sinara-hw/FMC_Shuttler/README.md

# Shuttler

16-channel 125MS/s 16bit DAC in FMC form factor.

## Design Files

Design files (schematics, PCB layouts, BOMs) can be found at [Shuttler/Releases](https://github.com/sinara-hw/Shuttler/releases).

## Wiki

More information can be found on the [wiki](https://github.com/sinara-hw/Shuttler/wiki).
