sinara-hw/FMC_Shuttler/(threads)

Thread 2 (2018-08-19):

[RFC] New AMC: Shuttler (high-speed multi-channel DAC)

marmeladapk, 2018-08-19:
_From @hartytp on [2017-08-16 05:24](https://github.com/sinara-hw/sinara/issues/253)_

I've started sketching out requirements for a fast DAC to be used for ion shuttling/splitting. It's on the [Wiki](https://github.com/m-labs/sinara/wiki/Shuttler).

All comments welcome...

tprzywoz, 2018-12-05:
Schematics are nearly done so question about AFE: what was the conclusion?
I noted only amplifier parameters: gain 3, supply +/- 2.5 V to give +/- 1.5 V at the output. Is it actual? What are the filter requirements?

dhslichter, 2018-12-05:
@tprzywoz answered in a new issue (this one is so bloated and long): https://github.com/sinara-hw/Shuttler/issues/3#issue-387849998

gkasprow, 2020-11-06:
nothing to discuss here, closing

Closed 2020-11-06.

Thread 3 (2018-12-05):

Shuttler AFE

dhslichter, 2018-12-05:
Breaking out to a new issue for the AFE design, in response to https://github.com/sinara-hw/Shuttler/issues/2#issuecomment-444438410.

LTC2000 wants a 25 ohm load impedance (40 mA output current for 1 V output).  There is already a 50 ohm termination to ground internally on the chip for each of IOUTP/IOUTN so we want to provide an additional 50 ohm termination to ground for each at the output pins.  Then we route traces over 25-ohm lines (50-ohm differential) to the AFE, using ADA4927.  One option is the solution below, gives 2 Vpk differential output (4V pk-pk) with 10.2 nV/rtHz differential output noise density.  Can't seem to get it much better by playing with components.
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

dhslichter, 2018-12-05:
@tprzywoz see above for an initial spec on AFE design, @gkasprow @hartytp check this out too and see if you have disagreements.

hartytp, 2018-12-05:
@dhslichter I'm going to let you lead on this design -- I already have enough on my plate with Sayma and all the EEMs I'm working on and don't have enough head space to contribute in a major way to this design review.

dhslichter, 2018-12-05:
@hartytp ack, I have been doing the same w/r/t Sayma and EEMs....

hartytp, 2018-12-05:
Divide and conquer... :)

gkasprow, 2018-12-05:
There is going to be another AFE outside of the Shuttler board?
We would need some control signals which need to be foreeen.
Did we finally decide which connector we should use? Shuttler can go up to 500MS/s (or even 800MS/s)  per channel, so I'm not really sure if SCSI is good choice here. We can use i.e. QSFP/SAS connectors and cables which have both 8 diff pairs and a few control signals.
With 3 such plugs we will connect all 18 channels + some high speed clock/data lines and a lot of LVTTL signals. The cables are available with various speed grades, so go up to 30GHz (3M Twinax)
You can get them [on cheap](https://www.amazon.com/CABLEDECONN-Internal-36-Pin-SFF-8087-Cable/dp/B00S7KU3PC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)
External ones are [more expensive](https://www.amazon.com/CableCreation-External-26pin-SFF-8088-Cable/dp/B013G4F5QK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), but still cheap.

gkasprow, 2018-12-05:
[These](https://cdn.amphenol-icc.com/media/wysiwyg/files/drawing/10117949.pdf) are nice cables. 8 diff pairs + 8 IO wires, rock solid connectors. It is external High Density SAS. Available i.e. [here](https://www.amazon.com/CableCreation-3-3FT-External-SFF-8644-Cable/dp/B01GPCTYEY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). One cay get them up to 10m long

dhslichter, 2018-12-05:
@gkasprow I have no desire whatsoever to try to run Shuttler past ~150 MSPS.  I understand that this doesn't make use of the full bandwidth of the DACs, but I don't want us to end up over-specing other components if there is no intent to go above ~150 MSPS.  I want to just make sure we keep this in mind as we develop.

That said, I imagine that the crosstalk on SCSI might be higher than we'd want, and that shielded differential pairs might be the best way to go.  I would want to use a reliable, COTS system, and these SAS and HD-SAS cables seem to be one option.

> There is going to be another AFE outside of the Shuttler board?
We would need some control signals which need to be foreeen.

Yes, there will be some kind of AFE to provide the final gain, filtering, differential-to-single-ended conversion that lives as close as possible to the ion trap.  Control signals might be nice to have if they are for free, but I had at least envisioned a "dumb" front end without things like switchable gain.  I also worry a little bit about digital crosstalk onto the analog signals if we send them down the same cable.  One could break out any digital signals into a separate cable/connector to address this.

gkasprow, 2018-12-05:
These digital signals go outside of twinax cables. They are usually loose wires inside plastic wrap. We can add also external connector, i.e. RJ45 and run LVDS signals over it for possible AFE control.

gkasprow, 2018-12-05:
SAS do not have side signalling, only HD-SAS and mini-SAS have ones.

dhslichter, 2018-12-05:
I would vote for RJ45/LVDS for digital AFE signals, and use the twinax cables for analog only.  Can you confirm the HD-SAS etc have individually shielded pairs?  I can't find a crosstalk spec anywhere (other than "at least 15 dB below insertion loss", which is not very tight), do you know of one?

gkasprow, 2018-12-06:
Yes, they do have individual pairs. They usually use 3M [twinaxial cables](http://multimedia.3m.com/mws/media/673519O/3mtm-twin-axial-cable-sl8800-series.pdf)
I use them in my projects so will measure the crosstalk.

gkasprow, 2018-12-06:
@tprzywoz please measure crasstalk of the twinax cables.

gkasprow, 2018-12-06:
@dhslichter why did you set Rs=25Ohm ? it is current output, so we need 50Ohm load impedance and traces can be 50Ohm as well.

dhslichter, 2018-12-06:
@gkasprow it is current output, but they want us to use 40 mA and have a 25 ohm load for the DAC to keep the output voltages between 0 and 1 V (+/- 1V differential), according to the datasheet.  There is a 50 ohm internal to the DAC, and we could use a 50 ohm transmission line and 50 ohm termination for the amplifier stage.  However, I am a little unclear because the DC path for the current feedback amplifier is such that we would end up running with 576 mV DC offset for the DAC channels, which would end up maybe giving us some issues with distortion as we go to full scale on the DAC.

If you look in the datasheet, they actually specify the DAC with 12.5 ohm total load (that is, 50 ohm DAC internal, 50 ohm DAC external, plus a 25 ohm load impedance at the front end of whatever following amplifier you're using).  This keeps the voltage swing down and I think ends up helping with the distortion

Here's a version with 25 ohm total load (50 ohm DAC plus 50 ohm at amp), showing what I mean about the DC offsets:
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

We can also turn the DAC current down (it can be set in a range between 10 and 60 mA) if that's easier, but it seems that spur performance is best at higher currents.  Anyway, this is something we should test -- I have an eval board but haven't had time to play around with it yet.

dhslichter, 2018-12-06:
regarding twinax, these look good (I remember your showing them before at some point).  It will be great to have a crosstalk measurement for verification but this seems like it would be a good solution.

gkasprow, 2018-12-06:
We have all HW needed to make crosstalk measurement.
I plan to attach 3 SMA connectors to the iPass connector where plug will be inserted.
I want to measure crosstalk between neighbouring pair and pair on opposite side of the connector.
Shall I attach baluns? Or just connect the signal to one of the diff pair wires and observe another?

dhslichter, 2018-12-06:
Ideally, baluns would be used, or single-ended-to-differential amplifiers otherwise.  We are looking for crosstalk at frequencies up to ~100-200 MHz max, so high-speed diff amps would work well also.

Just for a zeroth-order test, you could try putting a single-ended signal down one wire of one pair and see how much you see single-ended on a single wire of a neighboring pair.  That certainly gives a worse-than-worst-case crosstalk number.

Thread 4 (2018-12-06):

LVCMOS18 to LVDS - DAC data input

tprzywoz, 2018-12-06:
I made HyperLynx simulation of LTC-2000 data input lines with LVCMOS18 Kintex output. When single resistor was used as a DAC termination all results were nice like here https://github.com/sinara-hw/Shuttler/issues/2#issuecomment-414122354.

And now results with DAC ibis model:
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
Signal on + pin is shifted and also amplitude is reduced by the factor of 2.
I wrote a message to Analog support and i'm waiting for an answer because it could be ibis model problem but also something unexpected in internal termination circuit.

gkasprow, 2018-12-06:
The DAC datasheet says that VCM can be from 0.4V to over 1.5V.
But when we try to set 0.9V VCM it behaves like it was Thevenin terminated to roughly 1.2V inside.

dhslichter, 2018-12-06:
Be interesting to hear from Analog if this is an IBIS bug or if things are truly thevenin terminated inside.  The labels on the graph above are a little unclear -- does "DAC + input" mean pin DBP15?  If you put a resistor between the 0.9V bias and the DBN15 pin, can you figure out how strong the pull to 1.2V is?

tprzywoz, 2019-02-20:
The first answer after 2 months was: "We do not recommend driving the LVDS inputs single ended". I'm
 still trying to get more information...

gkasprow, 2019-02-20:
I ordered devkit  for LTC2000 so we will check it with Sayma AMC or other FPGA.

dhslichter, 2019-02-21:
thanks @tprzywoz @gkasprow.  Hopefully we can make this work, but if the IBIS model is right then we might be in trouble here.  We could think about using LVCMOS-LVDS bus translators like http://www.ti.com/product/SN65LVDS387 but these require 3.3V LVCMOS inputs (not sure we can get this out of all the FPGA banks) and consume about 280 mW each (!!).

gkasprow, 2019-02-21:
Anyway, even with 1.2V it should work. We will need to pull the matching network slightly up.

gkasprow, 2019-02-21:
@dhslichter the schematics are in the releases. Please have a look.

dhslichter, 2019-02-21:
Will look through schematics and let you know; it will probably be a couple of days before I can do through it all in detail though.

tprzywoz, 2019-02-26:
"The only way to test it to see if it is possible is to build it on the bench. "
So we are waiting for demo board...

tprzywoz, 2019-04-25:
Ok, so some results of test with DEMO 2303A.

Connections:
I connected demo board to Sayma_AMC and added 82R resistor to LTC2000 input (bit 14 - DBN14 and DBP14). It is not best termination but there is no other place to solder:
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
Kintex drives hi-z on all DAC data input pins except pin DBN14. DBP14 is connected to hi-z FPGA and also to resistive voltage divider (two 100R connected to DVDD1V8 - generate Vtt 0.9 V ) + capacitor 200nF.  Kintex output at DBN14 is LVCMOS18, DRIVE = 8, SLEW => SLOW.

Results:
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

I could change output voltage so we can drive LTC2000 with LVCMOS. There is a problem with oscillations when FPGA switches output but in my opinion it is only a consequence of the implemented "termination" (remember that distance between 82R termination and DAC is about 3 cm and I use resistive divider - not stable Vtt=0.9V).

gkasprow, 2019-04-25:
take into account that DAC is driven with 150MHz rate. So with such a poor matching, this looks good.

dhslichter, 2019-04-26:
Seems like a reasonable proof of principle!  What is the impact on power dissipation from the VT=0.9V on DBP14 drawing current from the DAC inputs?

tprzywoz, 2019-05-20:
Do you mean what is the impact of DAC inputs on VT circuit? I made another test: both FPGA outputs were hi-z, then I connected Vt to DBP14 with an ammeter. The result was 0 A.

gkasprow, 2019-12-22:
@tprzywoz please publish recent results that you included in your master thesis.

Thread 5 (2019-01-14):

DAC alignment

tprzywoz, 2019-01-14:
Do we need clock distribution to DACs with adjustable delay between channels?

dhslichter, 2019-02-12:
@tprzywoz @gkasprow the clock distribution for each DAC should be appropriately length-matched to the data traces for that DAC, but I don't think we care about whether these propagation delays are the same from DAC to DAC to less than ~1-2 ns (this should be very easy to achieve).  It is not important that the DAC outputs all update exactly synchronously.

gkasprow, 2019-02-18:
@dhslichter can you imagine application somewhere in the quantum lab where it could be important ?:)

jordens, 2019-02-18:
For very wideband applications the different group delays do make a difference and it would be nice to compensate then in hardware. Narrowband phase shifts are relatively easy to compensate in software.

dhslichter, 2019-02-19:
If it is easy to do, then go for it.  My main purpose is to avoid over-specifying the board in a way that makes it harder to design or more prone to failure/breakage.  @jordens I would think that any delays could be compensated for reasonably in software if desired.  I'm not clear on what you mean by "group delays" here?  Assuming this is all on the digital side that we are talking about, it's just a matter of whether the DACs are exactly synchronous in their output clocks (such that the phase is matched at the front panel analog output connectors, for example) or not.  While this is a nice goal in principle, I can't imagine that for fast ion trap electrode control (the goal of Shuttler) that sub-ns delay variation (static, mind you) would be an issue.

jordens, 2019-02-22:
Compensating for fractional, sub-sample, group delays in wide band applications is harder than compensating for a phase shift in a narrow band DDS. I would always prefer matching delays as good as reasonably possible on the board.

dhslichter, 2019-03-05:
I am fine with matching delays on the board as best as reasonably possible, no reason not to.  I just don't want to be doing crazy things for those last few picoseconds...

gkasprow, 2020-11-06:
not relevant here. we will have matched clock lines.

Closed 2020-11-06.

Thread 6 (2019-02-20):

Shuttler schematic review

tprzywoz, 2019-02-20:
I've just published schematics of Shuttler. I know that Sayma review must be done first to start Shuttler review, but I will be grateful for checking compliance with the expected specification -  I want to finish my master's thesis as soon as possible :)

gkasprow, 2019-07-24:
@tprzywoz Is this the last version of schematics? I want to introduce some changes and also do the review.

tprzywoz, 2019-07-24:
No, I changed the organization of FPGA schematics and fixed Sayma 2.0 issues that also affected Shuttler. I still have to finish some details. I'm going to push new version tomorrow.

tprzywoz, 2019-07-25:
I published the last version. What changes do we want to make?
My questions about potential changes:
As I understand a direct PORT0 connection to GTH is already working.  Can we remove ETH_PHY? / Do we want to wait for Sayma 2.0 to be sure?
Same question about Exar module.

gkasprow, 2019-07-26:
Let's leave as it is now. Do we miss some GPIOs?

tprzywoz, 2019-07-26:
If we want to implement EXT_CLK_IN / WR_REF_CLK_IN connected to FPGA then we need more IOs.
Also I thought about digital signals to control external AFE. Currently, we have 10 x 1.5V single-ended lines. We could add 3.3V lines without PHY.

gkasprow, 2020-08-14:
not relevant since we moved to FMC

Closed 2020-08-14.

Thread 7 (2019-02-21):

missing decoupling capas at the IC72

gkasprow, 2019-02-21:
There are FB connected to the supply pins. Aren't there missing decouplig caps?

gkasprow, 2019-02-21:
can the VOCM be left dangling?

dhslichter, 2019-02-21:
VOCM for the ADA4927s needs to be tied to ground.

tprzywoz, 2019-02-21:
> VOCM for the ADA4927s needs to be tied to ground.

Done

> There are FB connected to the supply pins. Aren't there missing decouplig caps?

Added according to datasheet: 1nF 100nF ceramic and 10uF tantalum capacitors for each supply.

dhslichter, 2019-02-21:
> Added according to datasheet: 1nF 100nF ceramic and 10uF tantalum capacitors for each supply.

Please make notations for voltage and dielectric spec (X7R or NP0) for the ceramic caps.  These amps may be driving a reasonable amount of current into the terminated transmission lines and so we want to make sure we don't have dc bias issues with the capacitors.

gkasprow, 2020-11-06:
it's not relevant anymore. we don't have any caps in the signal path in the FMC project.
I added a note on the AFE schematics

Closed 2020-11-06.

Thread 9 (2019-06-14):

Shuttler DAC parallel LTC2000 connection

tprzywoz, 2019-06-14:
I'm leaving results for future discussion.

As @gkasprow mentioned in #253 I made simulations for different FPGA output standards to check if it is possible to connect parallel LTC2000 (with internal LVDS termination) working with 150 MHz clock.

First configuration was 4 DAC to 1 IO bank of Artix-7. Only BLVDS standard meets the requirement of input voltage range (min +/- 200 mV). With 3 DAC we can use also SSTL18.

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
Example of schematic with 3 DAC

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
BLVDS simulation. Bit rate 600 Mbps.

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
SSTL18 simulation. Bit rate 450 Mbps

Closed 2019-06-14.

Thread 10 (2019-12-22):

DAC selection

gkasprow, 2019-12-22:
@tprzywoz finished layout of the board and want to close his master thesis. We decided that the main topic would be the optimization of the DAC connectivity that optimizes the price. He cannot wait longer for physical prototypes.
So, the question is what DACs should we choose? Do we stay with LTC2000 or can switch to a lower-cost alternative. I'd like to freeze the specification in early January.

dhslichter, 2019-12-23:
@gkasprow you should proceed however you see fit; we will still have to discuss the specification and I don't know whether this will be complete and ready to freeze by early January.  I think it is highly likely that we will NOT use the LTC2000 because of cost/power/complexity.  I am currently planning to target AD9117 as the DAC choice, with digital core at 1.8 V and analog at 3.3 V, tuned for 20 mA output current.  However, all of this is subject to discussion/initial testing/etc.  If you want to choose this DAC and freeze that spec for Shuttler 0.1, so that @tprzywoz can complete his thesis work, that is fine with me, however it is likely that we will have to come back and make various adjustments to do a proper Shuttler 1.0 design.

gkasprow, 2019-12-23:
We can switch to AD9117, I don't want to produce something that will be useless later on. What else would you like to change?

dhslichter, 2019-12-24:
Let me put up a draft spec in a day or two once there has been time for comment on my email to you and M-Labs.

gkasprow, 2020-11-06:
My colleague implemented dithering on this DAC devkit, he will test it and characterize within a 2..3 weeks. We can close it.

dhslichter, 2020-11-07:
@gkasprow we have been able to achieve 18 monotonic bits using dithering on a devkit for the AD9117 in tests at NIST before the pandemic hit.  The temperature coefficient is less well characterized, but appears to be helped by using an external reference.

gkasprow, 2020-11-07:
can you write more about the results and methods?

dhslichter, 2020-11-13:
Went into the lab and took some measurements today to verify the previous work.  The plot below shows the output voltage measured by a high-precision DVM with a slow time constant (~1 second) to reduce the noise.  There is a lot of pickup in the lab and the setup is definitely not optimized for noise, but this lets us see the trend at least.

The values here represent dithering around a major carry (digital codes 4095-4096) as well as with just the LSB flipping (codes 4096-4097).  The waveforms are very simple.  We output a looping digital waveform where for each 16 samples, the last (2,4,6,8,10,12,14) samples have a code one larger than the rest (e.g. 12 samples of 4095 followed by 4 samples of 4096 would be an average of 4095.25).  For some of the waveforms it was done in chunks of 32 samples rather than 16 samples, doesn't seem to make a difference with this extremely slow averaging.

In the end, this lets us get 3 extra effective bits that are nearly monotonic.  My student took some data several months ago showing 4 extra monotonic effective bits, but these were much closer to 0 V, and so less affected by gain errors/drifts.  These data are at the midpoint between 0 V and full scale (+/-1 V).

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

dhslichter, 2020-11-13:
Also took some measurements of temp coefficient.  I set up the DAC eval board with a temperature sensor IC bonded on top of the DAC chip with thermal paste, and then gently heat gunned the underside of the board and the surrounding box to get the temperature up to ~45-50 C.  Then I stopped the heat gunning and just recorded the output voltage along with the temperature of the sensor as the board slowly cooled back down to room temperature.  For an output of +1 V or - 1 V (full scale), I measured a voltage drift of 20 uV/C, with opposite signs (thus a gain drift of 20 ppm/C).  For an output of 0 V, the voltage drive was 1 uV/C.  These numbers are consistent with the datasheet, which claims a max gain drift of 40 ppm/C and a much smaller offset drift.

dhslichter, 2020-11-13:
The fluctuations of the output voltage at full scale on ~second timescales are fairly large, 10s of ppm, but this setup has basically not been optimized for noise at all.  I am a little nervous about these fluctuations, but I see so much pickup and switch mode spikes and such when looking at the output on an ac-coupled scope that I don't know how worried I should actually be.  It also appears that these fluctuations are smaller after some warmup period of 15 minutes or so.  This is something that will require much more careful lab setup and measurement if we want to get to the bottom of it.

gkasprow, 2021-01-24:
nothing to do here, closing

Closed 2021-01-24.

Thread 11 (2020-05-27):

[RFC] Shuttler GW/SW requirements specification

AAWO, 2020-05-27:
I've read through the issues regarding Shuttler and came up with requirements specification list. The final Shuttler's specification will also be a foundation for future ASIC (multi-channel DAC compatible with Sinara/ARTIQ) specification.

- 18 DACs (LTC2000) - PHY: 16 bit parallel output + clock each
- DRTIO Satellite interface
- DAC data rate = RTIO frequency -> single clock domain for DACs around 150MHz?
- data from DRTIO (all branches up to memory limit) is passed to SDRAM memory
- current waveform branch data is passed from SDRAM to proper DAC's sequencer FIFO - is such functionality already implemented in ARTIQ?
- 32-bit (16-bit?) timer counting until end point (received from DRTIO)
- each DAC's output waveform sample is updated when next sample's timestamp value is equal to current timer value
- a calibration procedure is needed to determine the latency between Master and Satellite's DAC output
- the raw data received from DRTIO is later on sent to DACs directly, or some DDS/interpolation is required?
- a single data packet received from DRTIO is (at proper time point) sent to DAC and dropped from memory/FIFO

I imagine the operation such that Master sends all experiment's data branches (DAC output value + timestamp + DAC ID + some branch ID) to Shuttler which stores it in the SDRAM - the amount of data sent by Master is constrained by the SDRAM. Then Master can send just current branch ID to Satellite.
Shuttler writes current data branch from SDRAM to required DACs' sequencers FIFOs. If the branch is changed before all data from FIFO is read, then FIFO is cleared and new data is written to it.
The timer can be started after Master's request. The timer's initial value should be dependent on the latency between Master and Shuttler's output as well as the delay between sending the 'start timer' request to next Shuttlers (which should be possible to determine by Master). This way all Shuttlers' timers should be aligned.

Part of the GW (namely: DAC handling) is going to be designed in Verilog, because later on it may be used as a test field for ASIC development.

dhslichter, 2020-05-28:
FWIW, although I have been occupied with other things these past couple of months, my current plan is to try to make a Shuttler design that is EEM/Kasli compatible, similar to how Phaser has been developed.  If others are interested in pursuing the specificiations above, perhaps we should branch or rename the EEM version to something else?

gkasprow, 2020-05-31:
Several questions arrive:
- would you need DRTIO? In new CPCIS form-factor, together with  ZUS+ the DRTIO in CPCIS will be supported. However, in EEM we would have a faster version of Fastino. Of course, we can connect DRTIO over SFP
- How many channels? We won't fit 24 probably. On the other hand if we use
XCKU035-1FFVA1156C, it's the same chip as CERN is using[ here](https://ohwr.org/project/diot/wikis/diot-fmc-carrier). We will get very good pricing, comparable with Artix
- what is the use case? how many channels would you need in total?
- if we go for CPCIS natively, we would get extra real estate and 24 channels would be feasible.

dhslichter, 2020-06-02:
Going for EEM would mean reduced channel count; I am also looking at ways to reduce power consumption by choosing different DACs and amps.  We were doing some DAC testing in the lab before the quarantine but that has been stopped, unfortunately.

If the CPCIS form factor works, that's great, but I am hesitant to be the guinea pig here.  My preference would be to develop a board as an EEM, which would allow us to get up and running, and ease the debugging process (as with Fastino and Phaser).  Down the road, if the design is proven out and there are advantages to using a single card as a DRTIO satellite, rather than running over EEM from Kasli, one could port a lot of the design over.

Total channel count desired would be something like ~100 for a given setup, possibly a bit more.  I think the primary limitation will be power dissipation in the rack, and thermal management.  I don't think we need 24 channels per card, 12-16 would probably be just fine.

gkasprow, 2020-06-03:
@dhslichter For the development of the Shuttler HW & GW we received already the research grant. It is clearly stated that it should support MTCA so we must somehow cope with it.
What if we make it in FMC form-factor? Then we could use it with low cost [AFC](https://ohwr.org/project/afc/wikis/home) carrier and also with [CPCIS FMC](https://ohwr.org/project/diot/wikis/diot-fmc-carrier) carrier. AFC/AFCK is well-tested solution (a few hundreds in operation), and now we are working on 4-th revision together with a few research institutions (CERN, LNLS, GSI, WUT).
The CERN CPCIS carrier uses very low cost (special Xilinx discount) Kintex US FPGA, already supported by ARTIQ.
With such an approach we could further fund the Shuttler development, meeting both funding agency goals as well as your requirements. We are working intensively with CERN on CPCIS, have suitable funding so soon the entire EEM ecosystem will be migrated to this ecosystem keeping full compatibility with existing EEM modules.
I already proved that [16-channel  * (ADC + CFD + TDC) ](https://github.com/elhep/FMC_ADC100M_10B_TDC_16cha/wiki)together with SAS connector is feasible on single FMC HPC.
I think 12-16 DAC channels per FMC can be done easily. I did a simple trick - the power section is placed on tiny mezzanine plugged to the FMC board and secured with 2 screws. Both boards are produced simultaneously with no additional cost.
With such approach, we will lower the cost significantly due to the economy of scale of AFC. The design and verification of such DAC would also be much lower risk and cost.
What we can do is to design two FMCs - one with LTC2000 and another with lower-grade DAC and see what approach is feasible in a real application.
In the past I already did 16-channel 14-bit [FMC DAC ](https://ohwr.org/project/fmc-dac100m14b16cha-adc2m14b4cha/wikis/home) and even managed to fit 4 ADC channels and some IOs.

kaolpr, 2020-06-04:
@dhslichter, @gkasprow - very interesting conversation. Interesting enough that it should have its own issue ;-). Please continue at #12 and let's leave this issue for comments on GW/SW specification as it seems to be at least partially independent.

kaolpr, 2020-06-04:
@dhslichter, @gkasprow - very interesting conversation. Interesting enough that it should have its own issue ;-). Please continue at #12 and let's leave this issue for comments on GW/SW specification as it seems to be at least partially independent.

AAWO, 2020-06-04:
> FWIW, although I have been occupied with other things these past couple of months, my current plan is to try to make a Shuttler design that is EEM/Kasli compatible, similar to how Phaser has been developed. If others are interested in pursuing the specificiations above, perhaps we should branch or rename the EEM version to something else?

OK, the form of the module, as well as the interface to ARTIQ is still to be discussed. Nevertheless, what about the rest of the proposed specification? Does it fit your use case?

dhslichter, 2020-06-12:
Replying to top post:

> 18 DACs (LTC2000) - PHY: 16 bit parallel output + clock each

Use AD9117 instead, 14 bit parallel LVCMOS bus with interleaved data (DDR)

> DRTIO Satellite interface

My current vision would be to have data streamed to a Shuttler from a Kasli, in the way that Phaser is done, so Shuttler itself would not need DRTIO.

> DAC data rate = RTIO frequency -> single clock domain for DACs around 150MHz?

Yes, 125 MHz (max clock for DAC, good general value for RTIO clock too)

> data from DRTIO (all branches up to memory limit) is passed to SDRAM memory

Again, I aim envisioning that reduced-representation data are streamed from Kasli to Shuttler.  The FPGA on Shuttler would be in charge of turning the reduced representation into samples at the full data rate.  For higher resolution, this MAY include performing sigma-delta modulation to increase the output resolution at ~DC.  Otherwise, would be simpler.

> current waveform branch data is passed from SDRAM to proper DAC's sequencer FIFO - is such functionality already implemented in ARTIQ?

Again, I envision this happening on Kasli.

> 32-bit (16-bit?) timer counting until end point (received from DRTIO)

Use the same architecture as for waveforms on Fastino or Phaser.

> each DAC's output waveform sample is updated when next sample's timestamp value is equal to current timer value

> a calibration procedure is needed to determine the latency between Master and Satellite's DAC output

Yes, TBA

> the raw data received from DRTIO is later on sent to DACs directly, or some DDS/interpolation is required?

See above, FPGA on board hosting Shuttler (via FMC, or directly) will need to do calculations to turn reduced representation of waveform into samples at full data rate.

>a single data packet received from DRTIO is (at proper time point) sent to DAC and dropped from memory/FIFO
> I imagine the operation such that Master sends all experiment's data branches (DAC output value + timestamp + DAC ID + some branch ID) to Shuttler which stores it in the SDRAM - the amount of data sent by Master is constrained by the SDRAM. Then Master can send just current branch ID to Satellite.

Let's do this in the same way that Fastino, Phaser, etc do it.

> Shuttler writes current data branch from SDRAM to required DACs' sequencers FIFOs. If the branch is changed before all data from FIFO is read, then FIFO is cleared and new data is written to it.
> The timer can be started after Master's request. The timer's initial value should be dependent on the latency between Master and Shuttler's output as well as the delay between sending the 'start timer' request to next Shuttlers (which should be possible to determine by Master). This way all Shuttlers' timers should be aligned.

Again, see above, do the same way as Fastino and Phaser.

kaolpr, 2020-08-27:
Comming back to GW specification:

>My current vision would be to have data streamed to a Shuttler from a Kasli, in the way that Phaser is done, so Shuttler itself would not need DRTIO.

Shuttler will be mounted on some FMC carrier (maybe [AFCv4](https://ohwr.org/project/afc/tree/wut_afc4) or CPCIe carrier like [this one](https://www.ohwr.org/project/diot-pfc-ku/wikis/home)). Such carrier can run in standalone mode or be a satellite to Kasli.

>Use the same architecture as for waveforms on Fastino or Phaser.

Up to my understanding, Fastino works in a different way than Phaser. If I'm to wrong, current GW for Fastino allows setting output levels at specified timestamps whereas [Phaser is AWG](https://github.com/quartiq/phaser). @dhslichter What architecture do you have in mind?

dhslichter, 2020-08-27:
I think the goal would be to be more like Phaser.  We're looking to have parameterized waveforms, with some combinations of sine waves and splines and products of these -- the specification needs to be determined still.  However, the waveforms would for sure be in some reduced representation that is not just (time, voltage) pairs.

kaolpr, 2020-08-27:
@dhslichter - how do you find the process of determining these specifications? Do you have any timeline for that? Do you think you can specifiy that?

dhslichter, 2020-08-27:
This is something that we want to contract with M-Labs to have them design for use with ARTIQ.  Are you wanting to design your own independent gateware to have it emit pulses, or are you planning to work with M-Labs on a solution for ARTIQ?  An official contract for this will take at least two months, maybe more.  However, if you are just doing your own independent thing to be able to demonstrate the functionality for grant purposes, we can just discuss a draft specification here on a short timescale.

kaolpr, 2020-08-28:
Is this contract going to give a rise to something more generic? I mean to be used throughout different boards, e.g. Sayma, Phaser, Shuttler, maybe Fastino? A generic waveform forming API for ARTIQ?

gkasprow, 2020-08-28:
The initial idea was to have just AWG functionality that is sufficient to run the production tests. If we can do easily something more sexy that makes the end-used happy, we can do that.

dhslichter, 2020-08-28:
> A generic waveform forming API for ARTIQ?

There already exist several different versions of this for e.g. Sayma and Phaser, and @jordens has proposed yet a separate parameterization in https://github.com/quartiq/phaser/issues/2 as well.  My general feeling is that the specific applications for ARTIQ are sufficiently varied that probably there isn't a one-size-fits-all method for generating all possible types of waveforms one wants.  Different use cases call for different parameterizations.

> The initial idea was to have just AWG functionality that is sufficient to run the production tests.

To be concrete, having waveforms defined as `A+B*sin(C*t)+D*cos(E*t)`, where `A,B,C,D,E` are all time-dependent functions decomposed into cubic splines, with arbitrary/adjustable time delays between spline knots, is a fine place to start for demonstrating functionality.  This is only one way in which one could parameterize outputs, and is probably NOT how things will end up in a written contract.

One feature of Shuttler that would be nice to implement, if you are looking for more of a challenge, is delta-sigma modulation of the output to increase the effective bit depth at DC to 16+ bits.  This could be an interesting gateware project if you are looking for something a little bit fancier to implement.  We did some test experiments at NIST with dithering to increase the low-frequency resolution and this should work.

dhslichter, 2021-04-28:
@gkasprow @AAWO my concrete suggestion for how to do the AWG in the gateware is as follows:

- implement a duplicate of the current PDQ gateware (adapted to whatever FPGA you are using).  Code and documentation are at https://github.com/m-labs/pdq and https://pdq.readthedocs.io/en/latest/
- this is a basic level functionality that will render the boards useful.  I suggest doing the computations of the output as 16 bit numbers, and then just round to 14 bits before sending to the DACs
- following this, there can be discussion of using sigma-delta modulation to increase the effective bit depth at DC.  The current work that has been done on random dithering with LFSR is appropriate for spreading noise, but doesn't do anything to increase effective resolution at DC.  For this you would want to use sigma-delta modulation.  There are hack-y ways to do this using dithering (not random dithering, though), which is why it was being discussed before, but probably sigma-delta is the right way to do.

gkasprow, 2021-04-29:
@kaolpr

dhslichter, 2021-05-14:
@kaolpr @gkasprow what is the status on this?  is there a gateware repo that exists somewhere?

kaolpr, 2021-07-06:
Generally we had some problems with DAC devkit we were working with. I'll looking into this in this month and hope to publish initial version of the gateware at the beginning of August.

dhslichter, 2021-07-06:
problems with devkit?  anything concerning?

gkasprow, 2021-07-06:
Devkit works with ADI software but for some reason doesn't work with ARTIQ. It looks like a DAC initialization problem.

dhslichter, 2021-07-06:
meaning that the SPI communications are broken?

kaolpr, 2021-07-07:
I was not actively taking part in the development up till now. I only know he couldn't get it working and I'll be looking into it as soon as I'm back from vacation (on 20th July).

This devkit exposes USB interface for programming DAC and clock tree configuration. From what I have seen so far, provided software is a bit confusing and I hope this is the source of the problem.

Thread 12 (2020-06-04):

Shuttler FMC

kaolpr, 2020-06-04:
During the conversation on HDL/SW specification, an idea of having Shuttler moved to the FMC modules has arisen. Let the authors speak:

>  @dhslichter FWIW, although I have been occupied with other things these past couple of months, my current plan is to try to make a Shuttler design that is EEM/Kasli compatible, similar to how Phaser has been developed. If others are interested in pursuing the specifications above, perhaps we should branch or rename the EEM version to something else?

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

> @gkasprow For the development of the Shuttler HW & GW we received already the research grant. It is clearly stated that it should support MTCA so we must somehow cope with it.
What if we make it in FMC form-factor? Then we could use it with low cost [AFC](https://ohwr.org/project/afc/wikis/home) carrier and also with [CPCIS FMC carrier](https://ohwr.org/project/diot/wikis/diot-fmc-carrier). AFC/AFCK is well-tested solution (a few hundreds in operation), and now we are working on 4-th revision together with a few research institutions (CERN, LNLS, GSI, WUT).
The CERN CPCIS carrier uses very low cost (special Xilinx discount) Kintex US FPGA, already supported by ARTIQ.
With such an approach we could further fund the Shuttler development, meeting both funding agency goals as well as your requirements. We are working intensively with CERN on CPCIS, have suitable funding so soon the entire EEM ecosystem will be migrated to this ecosystem keeping full compatibility with existing EEM modules.
I already proved that [16-channel * (ADC + CFD + TDC)](https://github.com/elhep/FMC_ADC100M_10B_TDC_16cha/wiki) together with SAS connector is feasible on single FMC HPC.
I think 12-16 DAC channels per FMC can be done easily. I did a simple trick - the power section is placed on tiny mezzanine plugged to the FMC board and secured with 2 screws. Both boards are produced simultaneously with no additional cost.
With such approach, we will lower the cost significantly due to the economy of scale of AFC. The design and verification of such DAC would also be much lower risk and cost.
What we can do is to design two FMCs - one with LTC2000 and another with lower-grade DAC and see what approach is feasible in a real application.
In the past I already did 16-channel [14-bit FMC DAC](https://ohwr.org/project/fmc-dac100m14b16cha-adc2m14b4cha/wikis/home) and even managed to fit 4 ADC channels and some IOs.

kaolpr, 2020-06-04:
Ops. Sorry for that.

dhslichter, 2020-06-12:
Doing developments on FMC seems to be a sensible idea.  One can then have the choice of different "carrier" boards as appropriate for MTCA/EEM/CPCIS, or just use a standard FPGA eval board to get things up and running (e.g. KC705).  I think a lot more of the questions come around what one chooses for the DACs, amps, etc.  Thinking about power budget, space constraints, and so forth.

Closed 2020-11-06.

Thread 13 (2020-06-12):

Shuttler DAC/amp design

dhslichter, 2020-06-12:
Proposal for Shuttler DAC and amplifier selection/design @gkasprow @kaolpr :

- DAC: [AD9117](https://www.analog.com/en/products/ad9117.html).  For output tones in the DC-15 MHz range (target), has very good noise/distortion/spurs.
    - two channels
    - 14 bits
    - 125 MSPS
    - 85 dBc SFDR, 82 dBc IMD for 10 MHz output tone
    - ~0.5 LSB DNL/INL spec after self-calibration (DNL tested OK, INL questionable)
    - -163 dBm/Hz noise floor @ 1 MHz, -157 dBm/Hz @ 10 MHz
    - use external reference, 1.25 VDC, ultra low noise and tempco desired.  Suggest [LTC6655](https://www.analog.com/en/products/ltc6655.html) as used in Fastino.  Gain tempco of DAC is spec'ed on data sheet at 40 ppm/C but this is with internal reference, which is not very good.  Measurement of gain tempco with good external reference still needed.
    - Use 3.3 V AVDD, 1.8V DVDD for reduced power consumption/improved SI (digital I/O is LVCMOS).  Using LVCMOS18 for digital interface also allows use with US FPGA or 7 series FPGA (no HR banks required).
    - 14-bit LVCMOS parallel data input bus runs DDR.  Some care is required to ensure deterministic latency from power-up to power-up, given de-interleaving re-timer (see datasheet).
    - SPI access also required for register programming
    - Estimated power dissipation ~100 mW/channel

- output: differential-to-differential output amplification with gain~5, made from one [ADA4896-2](https://www.analog.com/en/products/ada4896-2.html) per channel for good matching and very low noise.
    - 1.36 nV/rtHz, input referenced, including resistor noise effects, at G = 5 (see datasheet Table 13 for recommended resistor values)
    - amplifier GBW gives natural rolloff, might include pads for additional capacitor in feedback network to give further suppression of Nyquist image feedthrough if desired (option)
    - choose supply voltages to minimize dissipation (3 mA quiescent current per amp, 6 mA/DAC channel)
    - capacitive loads cause ringing, need some small series resistance to avoid problematic interactions with output cable capacitance

- board output would be differential voltages from output of amp stage, to be carried on 100 ohm differential pairs to remote AFE board.
- differential-to-single-ended conversion, additional gain, additional filtering, line termination, etc all on remote AFE board

- needs discussion/measurement:
    - DAC output/amplifier circuit topology and component values
    - DAC tempco measurements with external reference
    - output cable/connector specification
    - line termination scheme for remote AFE (will ac termination work OK?  reduces static dissipation, but introduces phase shifts)
    - choice of rails for output amplifiers

gkasprow, 2020-06-13:
For connectivity purposes, I'd like to use mini-SAS (internal ones since we have limited area on FMC). They have a 4-wire side channel that normally run SPI (HDD blinking LEDs). Cables are cheap and individually shielded, specified up to 12Gb/s. I use such cables in various analog designs.
What about supplying the remote AFE?
I did initial schematic and PCB placement, it looks feasible
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
The right-most PCB is a mezzanine with all supplies. I used this approach already and works fine. I will reuse already working module which delivers several low noise rails 1.8VA, 3.3V, 3.3VA,  5VA, -3VA
https://github.com/elhep/FMC_ADC100M_10B_TDC_16cha
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

gkasprow, 2020-06-13:
such FMC supports 16channels. Two double DAC chips are connected to same bus via level translator-buffer. It enables compatibility with both 2V5 and 3V3 VADJ boards.
The DACs have separate data and sampling clocks and require low Ts/Th of 0.25ns/ 1.2ns, so we have time to latch 4 data cycles per 8ns clock cycle. I want to use 74AVC20T245. Such buffers usually have skew below 1ns. In case of issues, we can run the board at 100MHz. This will probably require some calibration of clock phase using DCM or delay.
Another thing is the jitter. I assume we will operate it in wide-band mode, far away from sampling frequency, and use dithering, so clock jitter generated by FPGA is not an issue.

gkasprow, 2020-06-13:
It looks like we can also use DDR mode which will simplify timings a lot and use full DAC speed.
We have 34 * LVDS for LA
24 * LVDS for HA
22* LVDS for HB
Which gives 160 single lines.
To connect 16 DACs, we need 8 * 16 = 128 lines
Even if we restrict them to bank/clocking zones, we still manage to fit 16 channels.
Some XIlinx devkits have missing some HA and HB lines, but KC705 has them all; the AFC board can also work stand-alone.

gkasprow, 2020-06-14:
One word about the level translators. We actually don't need them because DACs work with 1.8...3.3V range. But I want to use them to isolate DAC from FPGA.

dhslichter, 2020-06-14:
Looking good, @gkasprow!  Some comments on the above:
- 16 DAC channels on an FMC would be high enough density for my purposes
- Let's plan to use DDR mode @ 125 MHz on the DACs, I would like to be able to run them up to full speed (125 MSPS/channel).
- Those level translators (SN74AVC20T245) don't look like they will run fast enough if translating to 1.8 V?  Datasheet quotes 210 Mbps at 1.8V output.  I prefer the idea of running the DVDD for the DACs at 1.8V, with the AVDD at 3.3 V.  We want the higher AVDD rail for better performance of the analog outputs, but can save ~25 mW per chip by using the lower DVDD rail (200 mW total for the board).  I also like the reduced potential for digital-to-analog crosstalk if we are using 1.8V DVDD.
- Why do you want to use a level translator?  I don't understand the need to isolate the DACs from the FPGA, sorry.  It seems to me that the potential for skew/timing problems is something we should avoid if we can.  Also, we will want to have a proper clock distribution system for the DAC clock, not using these translators, to get the best performance.
- Requiring a carrier board that has a fully populated HPC FMC (in order to run all the DACs) is fine with me.  KC705 has a fully populated HPC FMC so would work for this.
- I like the idea of a power mezzanine, but suggest we need some adjustments compared to the version you linked to above.  The rails we need are 3.3VA, -3VA, 1.8VD.  We want the lowest noise we can get here, as the experiment will be very sensitive to DAC noise.  Suggest LT3094 for -3V rail (to follow filtered buck reg TPS63710, as on current power mezzanine), and 2x LT3045 (one for DACs, one for amps) to supply +3.3V rail.
- suggest considering shielding cans for DACs?
- mini-SAS cables sound fine, side channel would be good to wire up for SPI communications (4 wire) between FPGA and remote AFE.
- remote AFE will have its own power supply.  Likely we will also break the grounds at the remote AFE (or at a minimum, maintain that option); since signals are fully differential coming out of the FMC, we can use a suitable differential-to-single-ended amp on the remote AFE to allow the grounds to float relative to each other within some acceptable range.

dhslichter, 2020-06-14:
Also: because DAC outputs are centered around 500 mV, we need a very low-noise 500 mV reference for the op amp noninverting inputs, so that the swing of the op amp outputs is correct for the gain.  It's OK if the output has a nonzero common mode voltage at DC, since the remote AFE will strip this off anyway.

gkasprow, 2020-06-14:
>    16 DAC channels on an FMC would be high enough density for my purposes
good

>    Let's plan to use DDR mode @ 125 MHz on the DACs, I would like to be able to run them up to full speed (125 MSPS/channel).

OK

>    Those level translators (SN74AVC20T245) don't look like they will run fast enough if translating to 1.8 V? Datasheet quotes 210 Mbps at 1.8V output. I prefer the idea of running the DVDD for the DACs at 1.8V, with the AVDD at 3.3 V. We want the higher AVDD rail for better performance of the analog outputs, but can save ~25 mW per chip by using the lower DVDD rail (200 mW total for the board). I also like the reduced potential for digital-to-analog crosstalk if we are using 1.8V DVDD.
>    Why do you want to use a level translator? I don't understand the need to isolate the DACs from the FPGA, sorry. It seems to me that the potential for skew/timing problems is something we should avoid if we can. Also, we will want to have a proper clock distribution system for the DAC clock, not using these translators, to get the best performance.

I had issues with 16bit ADC coupled with FPGA. The FPGA generates a lot of ground-bouncing noise. It adds up to the digital lines. The result was that I lost 2 LSBs and got funny patterns on the image (the ADC was part of CCD camera electronics). We can try without buffers in case of these DACs, because they have 14bits and don't have a fragile sampling and hold circuit.

That's why I was asking about jitter. If all DACs will run with the same frequency, I will add proper clocking, which will also deliver copy of clock to every FPGA bank used for DAC control.

   > Requiring a carrier board that has a fully populated HPC FMC (in order to run all the DACs) is fine with me. KC705 has a fully populated HPC FMC so it would work for this.

>    I like the idea of a power mezzanine, but suggest we need some adjustments compared to the version you linked to above. The rails we need are 3.3VA, -3VA, 1.8VD. We want the lowest noise we can get here, as the experiment will be very sensitive to DAC noise. Suggest LT3094 for -3V rail (to follow filtered buck reg TPS63710, as on current power mezzanine), and 2x LT3045 (one for DACs, one for amps) to supply +3.3V rail.

we will produce the supply mezzanine anyway, together with FMC. The existing design uses ADM7171 and ADP1740 LDOs for positive rails
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
And such circuit for negative rail.
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

The system was 8-bit so noise was not that important.

>    suggest considering shielding cans for DACs?

Do you mean to shield it against power supply mezzanine noise? We can make the bottom layer as a solid copper. I'd rather add it to the AFE circuit, but don't think it's necessary.
I can try if there is a place for it. If we scrap the digital buffers, the shield should fit.

>    mini-SAS cables sound fine, side channel would be good to wire up for SPI communications (4 wire) between FPGA and remote AFE.

We would have 4 wires per each 8 channels

 >   remote AFE will have its own power supply. Likely we will also break the grounds at the remote AFE (or at a minimum, maintain that option); since signals are fully differential coming out of the FMC, we can use a suitable differential-to-single-ended amp on the remote AFE to allow the grounds to float relative to each other within some acceptable range.

If we break the GND, additional passive CMC may be necessary

>Also: because DAC outputs are centered around 500 mV, we need a very low-noise 500 mV reference for the op amp noninverting inputs to make a proper fully differential amplifier circuit. It's OK if the output has a nonzero common mode voltage at DC, since the remote AFE will strip this off anyway.

So, we could avoid -3V rail ?

dhslichter, 2020-06-15:
> we will produce the supply mezzanine anyway, together with FMC. The existing design uses ADM7171 and ADP1740 LDOs for positive rails

I saw that schematic already, and the noise needs to be lower.  That's why I requested those other LDOs instead.  I would suggest just making a variant of that mezzanine (same board size/footprint, but different part numbers) that will meet the needs of this board better.

> So, we could avoid -3V rail ?

No, I don't think so, because we want a gain of ~5 on Shuttler itself.  This means that each of the differential outputs (after amplification) swings +/- 2.5 V from the output common mode voltage.  We want something like this amount of gain on Shuttler (in other words, not putting it all on the remote AFE board) to help mitigate noise pickup which may occur between Shuttler and the remote AFE, and because this level of gain represents a nice compromise in terms of graceful bandwidth rolloff (and avoiding peaking), input-referred noise, and power dissipation (due to the supply voltages needed).  It also reduces the amount of gain required on the remote AFE, which could then be a single-stage amp instead of needing two stages.

> If we break the GND, additional passive CMC may be necessary

Why?  I am not opposed necessarily, but I feel vaguely like they have caused some difficulties in other projects, right?

> We would have 4 wires per each 8 channels

I think that's plenty.  Depending on what one wants to do with the remote AFE board, these could be used to configure or read back data from a number of different things (analog switches, controllable gain, calibration ADCs, etc).  These are the HD mini-SAS, correct?

> Do you mean to shield it against power supply mezzanine noise?

The shielding would be for power supply noise from the mezzanine, or digital switching noise from the nearby FPGA, or from neighboring cards in the rack, or....basically, this is my paranoia wanting to be careful with these signals.  Careful routing of the analog signals should probably already win us a lot (internal layers with ground planes top and bottom and vias on the sides, for example).

> If all DACs will run with the same frequency, I will add proper clocking, which will also deliver copy of clock to every FPGA bank used for DAC control.

Yes, all the DACs would run at the same frequency.  This sounds good.

dhslichter, 2020-08-23:
Why do we have a P5V0 rail?  This will be the positive supply rail for the output op amps, right?  That can be 3.3 V for reduced power dissipation.  The DACs have a V_CM of 500 mV and swing between 0 and 1 V; with G=5 the output signal will have a common mode voltage of 500 mV again, with output voltages swinging between +3V and -2V.  The op amps are rated to run with 200 mV headroom on the rails, so this would still be OK.  We could move the 3.3 to 3.5 V, for example, if we were worried.

gkasprow, 2020-08-24:
I want to have a separate rail for opamps. It does not have to be 5V. We will reduce it to something like 3.5V.
The opamps have usually poor performance close to the supply rails. If we finally decide and test that 3.3 is enough, we can remove this rail.

dhslichter, 2020-08-24:
I think we should have a separate rail for the op amps -- I was just suggesting that we reduce the voltage from 5 V to ~3.5V.  We can have rails at -2.5 V and 3.5 V so that we have 500 mV headroom either direction, and can increase both directions a little if we need to.

Another reason we need a separate rail is that a single LT3045 won't be able to run all the DACs and all the op amps -- it only does 500 mA max.  The op amps will draw 16 * (2*3) ~ 100 mA quiescent current, and will be drawing more based on the terminations at the AFE.  The DACs draw (55 * 8) = 440 mA on the AVDD rail.  One rail for DACs, one rail for op-amps sounds good.

gkasprow, 2020-11-15:
@dhslichter did U have a chance to check the FMC card design? I'd like to start routing it ASAP because the project deadline is close.

dhslichter, 2020-11-17:
@gkasprow sorry slammed but will do tonight (USA time)

Thread 14 (2020-06-13):

AFE & supply

gkasprow, 2020-06-13:
What are the plans for supplying the  remote AFE?

dhslichter, 2020-06-15:
Remote AFE is a separate board entirely, with its own independent power supplies.  We just need to specify the interface between the remote AFE and the Shuttler FMC card for the analog signals, as well as for the digital (SPI) signals in the side channels of the cables.

My proposal:
- analog signals are provided over external mini-SAS
- analog signals are differential, with nominal common-mode voltage 500 mV (referenced to FMC ground)
- remote AFE should be configured as instrumentation-amplifier-type circuit to perform differential-to-single-ended conversion, provide gain, and tolerate common-mode offset of up to ~few V (high-impedance inputs, allows potential use of separate ground for remote AFE/ion trap that is not closely coupled to computer/FPGA ground)
- remote AFE provides differential termination (100 ohm, possibly ac coupled with knee at ~1 MHz).
- digital lines in side channels are all opto-isolated at remote AFE with DIP-switch-selectable line directions.

gkasprow, 2020-06-16:
sounds good. What supply range do you need?
Would you like to supply it from [Aux Power Suply](https://github.com/sinara-hw/meta/issues/48)?
Or from standard 12V wall wart (bad idea); or, some low noise +/- 12V bench supply?

dhslichter, 2020-06-17:
Let's defer the discussion of the remote AFE for the immediate time being.  My vision is that this should be a fairly simple "physicist"-type board.  We will likely want to put some reasonable consideration into the power supply, including noise testing.

gkasprow, 2020-06-17:
What voltage ranges do you expect at the ion trap electrodes?

dhslichter, 2020-06-19:
It will depend on the trap!  That's why we should leave the remote AFE as a separate task and not worry too much for now.  I'd say a "generic" value people have used in the past is +/- 10 V, but some may want +/- 20 V, +/- 50 V, ....

dhslichter, 2020-06-19:
The point is that different traps may call for different AFE designs.  I would like to leave the remote AFE as completely separate now and not worry about it, other than specifying 1. the connector it must use, 2. the termination for the analog signal, and 3. the ground potential difference it can tolerate relative to the Shuttler card.

gkasprow, 2020-06-19:
True, but we need something at the end of the cable to properly characterize the FMC design. Something simple that meets at least a typical use case.

dhslichter, 2020-06-19:
For a simple output board, use something with +/- 12 V or +/- 15 V output rails (could be moved up or down a bit as needed), with differential-to-single-ended conversion and a target gain of 2 or 2.5.  This would give a total output swing between +/- 10 V (or +/- 12.5 V).  A typical instrumentation amplifier or difference amplifier probably won't work because the bandwidth is not high enough (we would like ~15+ MHz bandwidth ideally).  Probably will need to build the circuit out of discrete op amps such as [LM6172](https://www.ti.com/product/LM6172) or [THS3121](https://www.ti.com/product/THS3121).  These have sufficiently high slew rate, low noise (including at low frequency -- we care about the 1/f voltage and current noise below 1 kHz), and low quiescent current.  Configure as a 3-op-amp instrumentation amplifier?

dhslichter, 2020-06-19:
The [LT1995](https://www.analog.com/en/products/lt1995.html) is another option with pin-strapped gain and internal resistors.  The resistors are not super well-matched, and the quiescent current of 9 mA means ~300 mW quiescent dissipation PER CHANNEL at +/- 15V supplies.  I would prefer to use discrete op amps with matched resistor arrays like this https://www.digikey.com/product-detail/en/vishay-beyschlag/ACASA1001S1001P100/749-1015-2-ND/4725768 which have 0.05% resistance match and 15 ppm/C tempco match for less than $1/channel, to build the difference amplifier stage.  Can use one resistor array for the buffers w/ gain, another for the subtractor stage.   Using +/- 15 V supplies with +/- 10V output voltage gives us some headroom to allow for common-mode voltage difference between the remote AFE and the FMC card.  Using a CMC on the input of the remote AFE would help raise the CMRR further at high frequency.

gkasprow, 2020-06-20:
Athat about the AFE form factor? Some Hammond extruded enclosure? What output connectors to the trap?

dhslichter, 2020-06-20:
Output to the trap: 25-pin d-sub for now, people can think about if they want to get fancier later.
AFE form factor: yes, probably would live in some cast aluminum box (not extruded).

dhslichter, 2020-08-23:
> Let's try to fit into the smallest one
> 100x50mm

Heat load will be a major consideration here.  Each LM6172, with +/- 15V supplies, has 138 mW quiescent dissipation, and we will use 1.5 per channel.  With 16 channels, this is 3.3 W quiescent dissipation.  This will of course be increased if there is lots of slewing going on.  I think it would be good to plan for some mechanism of heat sinking the op amps directly to the case.  We will also want to use a matched resistor array with a very good tempco matching between resistors, so we maintain good common-mode rejection over temperature.

gkasprow, 2020-08-24:
what about attaching the box to the optical table? Or, you don't want to dissipate heat there to keep the optics temperature stable. We can also attach the heat sink to the enclosure bottom and make good contact between PCB and the box wall.
In such case we need a bigger box since components will be mounted on one side

dhslichter, 2020-08-25:
In general you don't want to use the optical table as a heat sink.  My point was that yes, we may need a bigger box because we don't want the AFE to get too hot and that means heat sinking to the box itself.  It might be preferable to have a custom-machined aluminum pedestal for the PCB, (this can be done very cheaply) that then bolts to the inside of the box.  One could have large exposed (no silkscreen) metal ground pads on the backside that are then held in contact with the pedestal using screws.  You can carve out cavities in the pedestal for components on the back side, through-hole pins, etc.

gkasprow, 2020-10-20:
LEt's make it compatible with the [AUX_PSU](https://github.com/sinara-hw/AUX_PSU)

gkasprow, 2020-10-20:
@dhslichter This is the first iteration of possible AFE. We can use standard Hammond 1590BB2F die cast aluminium box.
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

The PCB is bolted to the laser-cut 2mm metal sheet that is later on bolted to the die-cast box. Only THT and some RC holes are cut in the sheet. This is super-cheap, less than 1$ per such sheet.
The upper cover has cutouts for connectors. It's also cheap to machine them in such way.
The LEDs are only for testing - the DIOs are optically isolated and drive the SPI register which controls LEDs.

gkasprow, 2020-10-20:
what about such AFE schematic?
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

gkasprow, 2020-10-20:
I assume you don't need variable gain or switchable filter.

dhslichter, 2020-10-22:
- At least for now, we don't need variable gain or a switchable filter.  This can always come later on some fancier designs if people want it.  I think resoldering is probably the best option rather than trying to implement hot switching, but it's worth thinking about in the longer run.
- I would use an ac termination for the input, otherwise we will have a needlessly large current draw on the Shuttler card itself.  I think at a minimum we should have pads to allow either RC termination or R=100 ohm termination (can just put a 0R on the C pads).  For starters, we might set the corner frequency at ~2 MHz (should be OK, assuming few-meter cable lengths), and one can always adjust this later in the testing stages by changing the capacitor value.
- It seems that R3 and R5 should match R1 and R8, and R6 should be larger?  Currently it looks like the gain of this circuit is ~100, we want gain ~2 or 2.5 IIRC (depends on exact gain on FMC card)

- One thing we could considering placing would be the ADC we are contemplating using to allow for calibration/slow feedback on voltages.  I would recommend using something like the [AD4115](https://www.analog.com/en/products/ad4115.html), which could basically be used to monitor all 16 channels and send measured values back over SPI.
    - AD4115 can handle voltages in the range +/- 20 V on each pin (single-ended measurements).  No external components required.  Could read directly from the output of the buffer amplifier (before R4/C5, to eliminate errors due to voltage division with ~1 MOhm input impedance of ADC).
    -  In order to correct for both gain and offset in the Shuttler DACs (e.g. due to temperature drifts), one would ideally be able to make measurements with several different output voltages.  However, if you have ions in the trap this might not be possible (i.e. voltages have to stay the same, or within some small range).  Therefore I think it might be useful to have an analog switch to disconnect the output connector from the AFE circuit.  The filter capacitors on the trap will maintain their voltages reasonably well for the duration of each calibration (~some milliseconds).  A relay would be best for this (low on resistance, high off resistance, no charge injection) but may not fit.  Analog switches are another option but on resistance and charge injection are important considerations.  The AD4115 has 4 programmable digital output pins which could be used with a 4:16 decoder circuit to control which switches are opened to allow DAC calibration.  All programmable over SPI, makes things simpler.

    -  The AD4115 has internal registers to allow compensation for ADC offset and gain error (one-time calibration).  It might be useful to have test points (doesn't need to be panel-accessible) to connect a laboratory precision calibrated voltage source for each of the ADC channels, so that one could calibrate the offset and gain for each ADC channel and send this information along on a datasheet for the board.  Tempco for gain and offset are very small (few ppm) so these calibrations would probably be

dhslichter, 2020-10-22:
output connector - is this 25 pin D-sub?

dhslichter, 2020-10-22:
In terms of relays to enable the DAC calibration sweep, I would recommend something like this part: [Pickering 109-1-B-5/2D](https://www.pickeringrelay.com/product/109-1-b-5-2d/).  SPST NC reed relay, switch/bounce times <1 ms, very small form factor (can fit 16 channels into 64 mm x 15 mm board area, we would just need to size up the Hammond box slightly), operates from 5 V with 7 mA, so we can drive directly from TTL/CMOS decoder, integrated diode.  A little pricey at $7 each, but I think we will want the ability to do frequent automatic calibrations on Shuttler.  One can make a board variant where the relays are bypassed by a jumper, so people can DNP and save money if they want.  We can get less expensive relays (<$2 each, saves $80/board) if we are able to use a bit more board space (100 x 20 mm) and use 1 Form A relays (normally open), which would mean dissipating 800 mW for keeping all the relays closed all the time unless calibrating.

gkasprow, 2020-10-22:
The connector is a high-density 26pin DSUB. Any preference here?

gkasprow, 2020-10-22:
@dhslichter there are also [OPTO-MOS](https://datasheet.octopart.com/AQY212EHAX-Panasonic-EW-datasheet-13536469.pdf) switches that have very low charge injection due to lack of steering circuit connection. It's a LED + solar cell + FET. 1.2$/pc

gkasprow, 2020-10-22:
Do you mean having one output connector for external precise DMM and 16 relays to selectively connect it to the AFE outputs?
And yet another 16 relays to disconnect the AFE from the trap?

gkasprow, 2020-10-22:
These [relays](https://www.pickeringrelay.com/product/116-1-a-5-2d/) are smaller and cheaper

dhslichter, 2020-10-22:
> Do you mean having one output connector for external precise DMM and 16 relays to selectively connect it to the AFE outputs?
And yet another 16 relays to disconnect the AFE from the trap?

No, I had in mind 16 relays to disconnect the AFE from the trap, and 16 test points (between output buffer and relay, on each channel), for a precision DMM (or a precision input source, alternatively, with output buffer powered off but ADC powered on).  This would only be accessible with the box open, you just do the calibration once as part of board test.  Another way to do this would be to have an external testing jig that plugs into the output connector, with switchable relays on that testing jig to connect to a DMM.  The issue there is that one has a voltage divider effect with the series output resistance of the RC filter and the DMM input impedance, which could be noticeable at the 16-bit level depending on DMM input impedance (10 MOhm vs 47 ohm = 4 LSB, for example).  If you have a >1 GOhm input impedance DMM then this is the simplest way to go, though, and you don't need the test points.

> @dhslichter there are also OPTO-MOS switches that have very low charge injection due to lack of steering circuit connection. It's a LED + solar cell + FET. 1.2$/pc

If an OPTO-MOS switch has low enough charge injection at the level we care about (we need charge injection to be ~10s of pC maximum, ideally less, over the entire range of source and drain voltages of the switch), it could work.  We also want the resistance to be low (<1 ohm is fine) e.g. AQY211EH.  We also want the on-state resistance to be independent of drain and source voltages; I suppose you get this with an opto-isolated relay but not with a typical semiconductor analog switch.

> The connector is a high-density 26pin DSUB. Any preference here?

Mostly it comes down to whether there are good, well-constructed shielded cable assemblies available.  Have you had good luck finding these with this type of connector?

> These relays are smaller and cheaper. And fit nicely

Yes, those were some of the ones I was looking at.  We will dissipate 800 mW steady state just running them, but if the rest of the board is already dissipating 3.3 W steady state maybe this isn't the end of the world.  These are slightly smaller footprint than the OPTO-MOS but it's similar.

Board design with relays looks nice, seems like things fit well!

dhslichter, 2020-10-22:
Another consideration with the optical relay is what the capacitance to ground is -- appears that there is a substantial voltage dependence of capacitance to ground, which would cause signal distortion.  If so we should avoid this.

gkasprow, 2020-10-22:
> > Do you mean having one output connector for external precise DMM and 16 relays to selectively connect it to the AFE outputs?
>> And yet another 16 relays to disconnect the AFE from the trap?

> No, I had in mind 16 relays to disconnect the AFE from the trap, and 16 test points (between output buffer and relay, on each channel), for a precision DMM (or a precision input source, alternatively, with output buffer powered off but ADC powered on).  This would only be accessible with the box open, you just do the calibration once as part of board test.  But now I think I see this is dumb, and a better way to do this would be to have an external testing jig that plugs into the output connector, with switchable relays on that testing jig to connect to a DMM.  The issue there is that one has a voltage divider effect with the series output resistance of the RC filter and the DMM input impedance, which could be noticeable at the 16-bit level depending on DMM input impedance (10 MOhm vs 47 ohm = 4 LSB, for example).  If you have a >1 GOhm input impedance DMM then this is the simplest way to go, though, and you don't need the test points.

What about using Hi-Z opamps + opto MOS switches? Of course this would add some capacitance and offset (a few tens of uV).
They could be cheaper than relays and would have one output for DMM

>> @dhslichter there are also OPTO-MOS switches that have very low charge injection due to lack of steering circuit connection. It's a LED + solar cell + FET. 1.2$/pc

>If an OPTO-MOS switch has low enough charge injection at the level we care about (we need charge injection to be ~10s of pC maximum, ideally less, over the entire range of source and drain voltages of the switch), it could work.  This is not specified in the datasheet and so would have to be measured, though (simple measurement).  We also want the resistance to be low (<1 ohm is fine) e.g. AQY211EH.  We also want the on-state resistance to be independent of drain and source voltages; I suppose you get this with an opto-isolated relay but not with a typical semiconductor analog switch.

they are 2-wire devices. They don't have a reference to GND, these are very low capacitances of optical bareer
The question is if leakage of disabled switch is acceptable

>> The connector is a high-density 26pin DSUB. Any preference here?

>Mostly it comes down to whether there are good, well-constructed shielded cable assemblies available.  Have you had good luck finding these with this type of connector?

You need to make the cable yourself. There are metal shields for DSUB connectors easily available.
We can also use fully shielded cables like SAS, but manual assembly could be problematic

>> These relays are smaller and cheaper. And fit nicely

>Yes, those were some of the ones I was looking at.  We will dissipate 800 mW steady state just running them, but if the rest of the board is already dissipating 3.3 W steady state maybe this isn't the end of the world.  These are slightly smaller footprint than the OPTO-MOS but it's similar.

Unfortunately they are not available as NC versions

dhslichter, 2020-10-22:
> What about using Hi-Z opamps + opto MOS switches? Of course this would add some capacitance and offset (a few tens of uV). They could be cheaper than relays and would have one output for DMM

If I understand correctly, this means putting on another set of 16 opto MOS switches -- one set to allow the output to be disconnected from the op amp (so that the voltages can be changed around for calibration), and another set to allow the op amp outputs to be routed to the single DMM connector.  Is that right?  Do we have enough space for that?

> they are 2-wire devices. They don't have a reference to GND, these are very low capacitances of optical bareer
The question is if leakage of disabled switch is acceptable

Assume that calibration of a single channel requires 100 ms.  The capacitance on the trap filters is typically something like 1 nF.  We would like to keep voltage changes to ~10s of mV at the worst during the calibration.  So this means that we can tolerate something like 100 pA of leakage current at voltage differentials up to ~25 V (max output swing of amps).  There is some wiggle room here potentially but that's the level of leakage current we are looking for.

> You need to make the cable yourself. There are metal shields for DSUB connectors easily available.  We can also use fully shielded cables like SAS, but manual assembly could be problematic

I have a strong preference for being able to use COTS cables (you can always make custom if you want it, but don't want to be forced to), so regular 25-pin D-sub would be preferable.

> Unfortunately they are not available as NC versions

Yeah I looked for that too.

gkasprow, 2020-10-22:
> > What about using Hi-Z opamps + opto MOS switches? Of course this would add some capacitance and offset (a few tens of uV). They could be cheaper than relays and would have one output for DMM
>
> If I understand correctly, this means putting on another set of 16 opto MOS switches -- one set to allow the output to be disconnected from the op amp (so that the voltages can be changed around for calibration), and another set to allow the op amp outputs to be routed to the single DMM connector.  Is that right?  Do we have enough space for that?

no, just 16 buffering opamps connected to the outputs + optoMOS or mux (we don't care about charge injection here)
It seems relays would be cheaper anyway. We will have calibration ADC anyway, so DMM wouldn't be used everyday probably.
DMMS have Gig OHMs in 200mV or 2V range, higher ranges use dividers and offer lower impedance

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

we should fit within 100pA
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

but the capacitance varies significantly
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

Ok, we have a place for regular D-sub. There are cables for High density versions, but hot shielded.

dhslichter, 2020-10-22:
> no, just 16 buffering opamps connected to the outputs + optoMOS or mux (we don't care about charge injection here)
It seems relays would be cheaper anyway. We will have calibration ADC anyway, so DMM wouldn't be used everyday probably.
DMMS have Gig OHMs in 200mV or 2V range, higher ranges use dividers and offer lower impedance

The purpose of this is DMM connection would be to calibrate the ADC once (not something that needs to happen often).  The ADC is already pretty good right out of the box with self-calibration, with 0.05% gain error + 1.5 mV offset error, and this calibration is to make those numbers even better if desired.  You need a nice DMM to do substantially better.  The ADC has calibration registers which you would then program on power-up with these values.  These should be pretty static in time, so you just figure out what the values should be once (i.e. when testing the board), and save them/ship them in the test report so they can be re-programmed in at power-up each time.

If we have enough space for another 16 opto-mos relays, then we can use them to connect the output channels to a single BNC or SMA output connector from right after the buffer, but then we also need to have some digital lines to control which channel gets sent to that output connector.  Since this is generally only a one-time "factory"-type calibration, my idea was that one could use test points on the board and keep things simpler.  Such test points would make it possible for someone to redo the calibration in their lab if they want to.  But I don't think we need to have a port for actively monitoring the voltage output lines.  If people want to do that, they can build some additional inline adapter board that plugs into the D-sub output connector, etc.  I think this is not a typical use case, as long as we have a calibrated ADC on board.

> we should fit within 100pA

yes, it seems to be good on that front

> but the capacitance varies significantly

after reading the data sheet, though, I think this refers to the capacitance between the input and output pins, so really it is only important because it presents a potential path for signals to couple even when the switch is nominally open.  For these small capacitances, I don't think we would expect much feedthrough, because when the switch is open we would only have static voltages on because we are calibrating the DAC on that channel.  So I think this is OK.  What would be a problem would be capacitance to ground that was voltage-dependent.  This means that we would get voltage-dependent rf feedthrough if we were driving a sine wave with the DACs, which is not an issue for us.

Looks like AQY211EHAX is what we want -- if we find that it somehow has issues with the voltage swings (only can take 30 V across the switch when open) we can go to the AQY212EHAX, which has slightly higher resistance but can tolerate 60 V.

> Ok, we have a place for regular D-sub.

I also think this just makes it a little less exotic (even though I agree D-subs are large and clunky, but they are not larger or clunkier than this box right now).

gkasprow, 2020-10-22:
So, if it is only "factory" calibration, why do we need the relays?
Or, do you plan to use relays to cancel the DAC noise during experiments?

dhslichter, 2020-10-22:
> So, if it is only "factory" calibration, why do we need the relays?
> Or, do you plan to use relays to cancel the DAC noise during experiments?

Sorry for the confusion.  There are two different calibrations that occur.  One is a calibration of the ADC, which is only a "factory" calibration.  The ADC has very low thermal drifts and so it should be pretty steady.  It is certainly much steadier (based on the spec) than the DACs and amplifier gain resistors.

The second calibration is a regular re-calibration of the gain and offset of the each of the DAC channels, which can come from drifts in the DACs on the FMC, the differential buffer amplifier stages on the FMC, and/or the AFE amplifier stages.  The goal here is to use the ability to perform somewhat regular automated recalibrations to compensate for these drifts in the digital waveforms sent to the DACs.  Even though the DACs are only 14 bits, we are planning to use dithering/sigma-delta modulation to achieve an effective 16+ bits at DC (at NIST we have measured that we can get 18 bits, monotonic, at DC in this way with an eval board).  Such re-calibrations cannot be performed when the DAC channels are connected to the ion trap electrodes, because you have to change the DAC voltage by a lot and this will probably make the ion(s) leave the trap 😁 So ideally you would have some relay that allows you to disconnect a DAC channel from the trap briefly (the capacitance of the filters on the trap, after the AFE board, act like a sample-and-hold and maintain the voltage, as long as we keep leakage current low), so you can use the ADC to do a calibration of the DAC channel gain and offset.  Then you set the DAC back to its correct value, reconnect to the trap, all set.  Repeat for the other channels.  Then hopefully this calibration will be steady for some time until it needs to be redone (thermal drifts, etc).

I do NOT think we need relays for the ADC calibration -- this could just be test points (in theory), although for an automated test jig you might want to use some other system (relays, or a test board that plugs into the output connector, or...).  We definitely WILL need relays for the DAC calibration, because that has to happen in an automated way while hooked up to an ion trap (you pause your quantum computing experiments to recalibrate the DACs).

dhslichter, 2020-10-22:
If the ADC is connected to the output buffers at all times, then you can also just perform periodic checking of the output voltages, either for debugging purposes or to know when a particular DAC channel seems to have drifted too far out of calibration.  Then you can decide if you need to do a full gain/offset recalibration of that channel.

gkasprow, 2020-10-23:
Thanks, now it's clear to me. We can use dual foorptints with both reed relays and OPTO-MOS with the latter ones installed.
Remember that ADCs have a sampling circuit that causes quite a high charge injection. I used to observe a few hundred mV sampling pulses on 1k input series resistors. That's why you need a low impedance ADC driver or when sampling rate is low, a capacitor which serves as a charge buffer. So I would make two copies of the output filters  - one for traps another for ADC

dnadlinger, 2020-10-23:
Wouldn't you rather want to have a slow, DC-accurate op-amp tapping off the single-ended output to the trap, so you can calibrate out any offsets from the fast op-amps?

gkasprow, 2020-10-23:
I mean a copy of the lowpass filter so the sampling current pulses produced by ADC do not interfere with trap electrodes.
To buffer with opamps, we would need 16 low offset amps.

dhslichter, 2020-10-23:
It looks like the ADC has integrated input buffers already.  There might be some charge injection due to the multiplexer switch?  However, it seems to me that if we connect this ADC to measure between IC3A and R4, and had a fairly aggressive (~10 kHz) low-pass RC with large capacitance between that node and the ADC input (using a fairly large C), it could help to smooth any glitch that comes from the ADC and reduce any impact on the trap electrodes.

The challenge here is that the finite ~Mohm input impedance of the ADC will give a voltage divider effect if we use an RC filter here.  A low-offset buffer would do the trick, but more parts (and expensive usually).

This voltage divider effect could just be considered to be part of the system calibration (the "factory" calibration of the ADC), as long as its tempco is sufficiently small (which would have to be tested).

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

Thread 15 (2020-06-14):

clock distribution

gkasprow, 2020-06-14:
I plan to use clock distribution IC with LVCMOS outputs.
Clock input would be selectable:
- Carrier FMC CLK3 BIDIR, where DRTIO recovered clock is present
- 125MHz onboard generator, either 125MHz oscillator or delivered by clock chip PLL
- external clock input delivered by MMCX front panel input

gkasprow, 2020-06-14:
Clock would be delivered to the following circuits:
- 8 x to DACs
- 4 x to FPGAs (2x LA, HA, HB)
- 1 x FMC CLK1 to enable further distribution in multi-board scenario

gkasprow, 2020-06-14:
There are several clock ICs that fit requirements. Examples are:
- [LMK03806](https://www.ti.com/lit/ds/symlink/lmk03806.pdf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)
- [AD9516 ](https://www.analog.com/media/en/technical-documentation/data-sheets/AD9516-0.pdf)

gkasprow, 2020-06-14:
the ICs above won't work. We need 1.8V LVCMOS.
The [ADCLK854](https://pl.mouser.com/datasheet/2/609/ADCLK854-1502771.pdf) seem to fit better

gkasprow, 2020-06-14:
I can add Si549 oscillator as the on-board clock source

gkasprow, 2020-06-14:
the ADCLK854 can be confgured as 16 LVCMOS outputs + 4 LVDS outputs. We need LVDS to route to FMC CLK inputs

dhslichter, 2020-06-15:
I like this part (especially because there are no registers to program!)  For the clocking, we need to ensure that the FPGA carrier board has the method to properly recover a high-quality clock from DRTIO (you are doing this already for other projects, right?), because this is the most likely thing that people will do.  Si549 is useful for debug.

gkasprow, 2020-11-06:
the new revision of AFC and DIOT carrier have already DRTIO clock recovery. Moreover, we can use SI549 as a part of digital PLL. External clock is also possible.

Closed 2020-11-06.

Thread 17 (2020-11-13):

Schematic review: AFE

dhslichter, 2020-11-13:
Overall I think this looks very nice @gkasprow!  Various thoughts below:
- [x] R11, R13 wrong values (A through H)
- [ ] would be good to do SPICE analysis for amplifier noise given resistor values (I can't do all the noise sums in my head).  Optimum source impedance seems to be ~12 kOhm given input voltage and current noise spec.
- [x] Is there any value in splitting the RC terminations (R32, C34; R46, C35) into either R-C-R or C-R-C so they are symmetric with respect to the signal lines?
- [x] with no voltage regulation on board we are potentially setting ourselves up for large crosstalk because the PSRR of the op-amps is not great above ~100 kHz (50 dB @ 1 MHz, 30 dB @ 10 MHz).  With op-amps potentially driving even 10s of mA of current when running oscillating signals at a few MHz, I don't know if the on-board capacitance is enough to keep the rails from fluctuating substantially.  It also leaves us more open to switch-mode noise that gets on the rails between the power supply and the AFE box.  I would strongly prefer to have LDOs on board (see next comment also).
- [x] LM6172 specs output swings in worst case of +/-12.5 V from +/- 15 V rails (lower for higher current draw, if we are sending MHz signals through).  If we give +/- 12 V rails, it's not clear that we will be able to make the full swing to +/- 10 V for the output.  Might make sense to use +/- 15 V in, with onboard high PSRR @ MHz frequencies LDO to take that down to +/- 13 V or so?
- [x] P5V0 rail will get a lot of garbage when the relays switch, any concerns there?
- [x] AVDD on the AD4115 needs to be 5 V, per data sheet, not 3.3 V.  This 5 V should not be the same rail as the relays (currently P5V0) because that is a dirty rail.
- [x] there are 16 relay channels but only 8 indicator LEDs?

gkasprow, 2020-11-13:
I added an LDO for ADC 5V generation. It consumes 10mA of the current total (analog + digital) so LDO will dissipate roughly 80mW

gkasprow, 2020-11-13:
16 LEDs will fit
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

gkasprow, 2020-11-13:
I added 3.3V LDO for LEDs and logic. It's derived from 5V rail.
5V rail is used only for relays and LEDs.

gkasprow, 2020-11-13:
Let's add LT3045 and LT3094 LDOs generating +/- 13V out of +/- 14..15V

gkasprow, 2020-11-13:
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

gkasprow, 2020-11-13:
I don't think that for this frequency range there would be any impact of split termination. But, with the resistor removed, there will be impedance imbalance. One needs to remember to remove or mount both components. I have a place on the PCB so I will add another capacitor to make sure we have a fully balanced pair.

dhslichter, 2020-11-13:
With LDOs added, do we want to remove the individual ferrites for each op amp?  The ferrites on the LDO inputs should help with any switch-mode spikes from the supplies, but then if we have them between the LDO and the op amps then the LDO can't do as good a job regulating the supplies for higher-frequency signals?  Recall that we may have signals of 10-15 MHz even being generated for some applications.

dnadlinger, 2020-11-13:
> […] then the LDO can't do as good a job regulating the supplies for higher-frequency signals?

I'd expect any current draw above about 1 MHz to be mainly sourced from decoupling caps, even with the new breed of very nimble LDOs. The low-pass filters formed from ferrites and decoupling caps might help localise any effects from insufficient capacitance, rather than causing more complex crosstalk issues.

gkasprow, 2020-11-13:
Yes, their role is crosstalk mitigation rather than RF isolation.
For low frequency, they are nearly pure resistance.

Closed 2021-05-22.

Thread 18 (2020-11-17):

Schematic review: FMC card

dhslichter, 2020-11-17:
Again, looks good overall @gkasprow.  Comments and questions:

- [x] FSADJ resistors should be chosen for 20 mA FS current instead of 10 mA.  This improves noise performance.  Value of R3, R4 should then be 2 kOhm for 1.25 V reference.
- [x] Note on schematic that FSADJ resistors (R3, R4) should be low tempco (10 ppm/C is good).
- [x] DVDD (pin 7) on U1 not connected to power rail.  Should be tied to DVDDIO
- [x] VADJ_BUF does not appear on schematic
- [x] adjust amplifier resistors R34, R35, R37, R38 to account for increased I_FS (divide all values by 2)
- [x] include pads for capacitors in parallel with R35 and R38 to allow single-pole low-pass if desired.
- [x] SPICE simulations for output noise of amplifiers on DAC AFE, in particular to include amp noise and effects of resistor values.  AD9117 has ~38 pA/rtHz current noise spec, about 3.5x the current noise of the amp, so this likely changes desired resistor values.
- [x] for discussion - series pads directly before IC2 pins 3 and 5 to allow for bias current correction resistors?
- [x] reduce common-mode voltage for AFE output (currently 1.25 V; can we make this equal to R34*10 mA~0.5 V?  This would mean this value would also be the CM voltage for AOUT_P and AOUT_N).  Using REF0V625 would be fine for this.
- [x] note on schematic to match resistors R34 and R37, R35 and R38 (neighboring positions on tape?), also low tempco for all four (25 ppm/C or better ratio).
- [x] are there any guarantees about FPGA banks for the different FMC pins?  IIRC the answer is "no".  Ideally we would not want to split data bits, or data and clock, across banks for any given DAC chip.  However, running at 125 MHz DDR this may be acceptable?
- [x] did you decide to get rid of voltage translation buffer chips between FPGA and DACs?

More to come tomorrow, will edit top post to add.

gkasprow, 2020-11-18:
The FSADJ are already 10ppm. I replaced with 2k0

gkasprow, 2020-11-18:
DVDD is not connected intentionally. I drive DVDDIO from VADJ to make sure it works with 1.8 and 2.5V FMC signaling.

gkasprow, 2020-11-18:
Indeed, there is a missing LC filter between VADJ and VADJ_BUF

gkasprow, 2020-11-18:
Won't the bias currents of both amps compensate each other?

gkasprow, 2020-11-18:
all DACs and their clocks are within the same FPGA banks. FMC says which clocks are for which data lines. Some carriers split LA lines between 2 banks - one must make sure the right clocks are used to clock these data

gkasprow, 2020-11-18:
R34, R38 = 249R; R34, R37 = 105R

gkasprow, 2020-11-18:
We are already using REF_0V625 for AFE :) I will rename the REF signal to AFE_REF to avoid confusion

gkasprow, 2020-11-18:
I removed the voltage translation chips between FPGA and DAC because the DAC already supports the 1.8-3.3V operation (VADJ range)  and  the buffer skew reduces the timing budget

dhslichter, 2020-11-18:
> DVDD is not connected intentionally. I drive DVDDIO from VADJ to make sure it works with 1.8 and 2.5V FMC signaling.

OK, I got confused there.

> Won't the bias currents of both amps compensate each other?

They are not super well matched: -11 uA typ, ranges between -17 uA and -4 uA.  My suggestion was primarily about getting pads in place (can populate with 0R) to allow this to be changed later if desirable.

> all DACs and their clocks are within the same FPGA banks. FMC says which clocks are for which data lines. Some carriers split LA lines between 2 banks - one must make sure the right clocks are used to clock these data

My question is -- is this a function of the specific carrier board, or is it specified in VITA 57.1?  My worry is that different FMC carrier cards might implement differently, and now you have some DACs/clocks split across banks.

dhslichter, 2020-11-18:
Still haven't completed all aspects of schematic review, will try to get it done tonight if possible.

gkasprow, 2020-11-18:
Yes, clock/banks arrangement is defined by VITA specification

gkasprow, 2020-11-18:
I routed the PCB - it still needs cosmetics, DRC and SI/PI checking

gkasprow, 2020-11-18:
the pdf is in releases

gkasprow, 2020-11-19:
the noise analysis
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

dhslichter, 2020-11-24:
Some questions -- the current source I1 is not the right value (should be 10 mA), also the DAC can be modeled as a current noise source with 38 pA/rtHz (datasheet).  Not sure where the 1/f knee is.  And the output noise shown here is differential noise, referred to the output?

I think that the values of R1 and R3 should be 50 ohm, not 100 ohm?

filipswit, 2020-11-29:
- [ ] ADCLK854: Outputs 0 to 3 are set to be LVDS outputs and 4 to 11 are CMOS, so DAC_CLK7 shouldn't use 3rd output.

gkasprow, 2021-01-24:
the opamp has a drift of 3nA/K and max input current of -11...-17uA.
If we don't compensate it, the input offset value would be -600uV which is much higher than the typical Vos of 28uV
The bias currents will compensate to some extent, but if one of the inputs has -11uA and another -17uA, the imbalance would be still 6uA, which will end up with a much higher offset than Vos.
So let's add resistors at the positive input of opamps. I have to fit them somehow.

OK, so I added the noise source of the DAC. I added the FB capacitors as well.
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

gkasprow, 2021-01-24:
after adding bias current compensation resistors
![Uploading obraz.png…]()

Closed 2021-02-23.

Thread 19 (2020-11-29):

Schematic review: FMC DAC PSU

filipswit, 2020-11-29:
- [x] IC46 wrong voltage divider. Vout=0.6*(1+130k/18k)=4.93, 51k and 18k will give 2.3V

Power budget doesn't seem to be completely actual but it doesn't cross any limit with actual ICs

Closed 2021-01-24.

Thread 20 (2021-02-11):

SAS connector availability

kaolpr, 2021-02-11:
SAS connector given in the project (Molex 75783-0107) is hardly available with MOQ of 750. Though we all hope Shuttler will spread like hot cakes, to make production easier let's change it to 75783-0136.

dhslichter, 2021-02-12:
As long as this remains compatible with the desired cabling, sounds fine.

gkasprow, 2021-02-23:
they differ slightly but are pin-compatible

Closed 2021-02-23.

Thread 22 (2021-04-15):

FMC schematic: AD9117 DVDD output shorted to DVDDIO

mkiepiela, 2021-04-15:
DVDD (internal LDO output) must be disconnected from DVDDIO when supplied from external source (V_ADJ).
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

Disconnect and bypass DVDD output with 1 uF to GND.

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

dhslichter, 2021-04-15:
Do we need to maintain the potential for adjustability of the DVDDIO rail?  At least in my view, it is preferable to always require that the DVDDIO rail be at 1.8 V.  This lowers power dissipation on the DAC as well as the FPGA driving the digital lines, and running 1.8V signals instead of 3.3V signals reduces EMI.

gkasprow, 2021-05-22:
the LVDS won't work with 3.3V anyway. So we should support 1.8 and 2.5V only and this is the way I design all FMC boards. We should add 0R + 1uF to support 2.5V VADJ. We have a place for PCB for that.

gkasprow, 2021-05-22:
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

Closed 2021-05-22.

Thread 23 (2021-04-15):

FMC PCB review: few points to improve

mkiepiela, 2021-04-15:
- [x] Add board name and revision number on overlay.

- [x] Add one more via on N3V0A.

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

- [x] Increase the distance between DAC_CLK lines to avoid crosstalk and increasing of sampling clock jitter.

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

gkasprow, 2021-05-22:
fixed

Closed 2021-05-22.

Thread 24 (2021-04-15):

FMC_DAC_PSU PCB review: strong coupling between noisy P12V0 and clean analog supplies

mkiepiela, 2021-04-15:
There is strong capacitive coupling between P12V0 plane on P4 layer and clean analog supply polygons on adjacent P3 and BOTTOM layers (P3V3A, P5V0A and N3V0A).
For assumed PCB stack-up and areas of polygons on P3 and BOTTOM the coupling to P12V0 reach the level of even dozens of pF.

Recommendation: split the P12V0 plane on P4 layer and connect to GND the areas under/upper supply polygons on P3/BOTTOM.

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

gkasprow, 2021-05-22:
I moved the P12V0 to bottom layer. P4 is GND.

Closed 2021-05-22.

Thread 25 (2021-04-16):

FMC schematic: DAC_AFE - differential output not inverted?

mkiepiela, 2021-04-16:
DAC_AFE works as inverting amplifier, however differential input and output signals are not inverted (_P/_N marks not swapped).
Maybe swap output _P/_N lines or at least add some comment on schematic chart, because it can be little misleading.

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

gkasprow, 2021-04-16:
good catch :)

gkasprow, 2021-05-22:
fixed
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

Closed 2021-05-22.

Thread 26 (2022-01-11):

General Status Update

adbr8389, 2022-01-11:
@gkasprow @tprzywoz we (Ions storage) are curious if there any updates regarding the status of the shuttler design

gkasprow, 2022-01-12:
That's a question to @kaolpr. He produces it currently.

kaolpr, 2022-01-12:
We're expecting to have prototypes in ca 6 weeks. After that we'll need some time (+ca 4 weeks) to test and verify hardware and firmware.

adbr8389, 2022-01-12:
Great, thanks for the response.

adbr8389, 2023-03-16:
@kaolpr I am getting some impression of the status of the shuttler prototyping from the issues - seems like progress is being made but things are still firmly in the prototype and debug stage. Could you quickly give me a (short) coherent story of what is happening on your end? Thanks!

kaolpr, 2023-03-17:
Well, we do have v1.0 up and running. At TechnoSystem we used Digilent Genesys 2 with some minimal sample lookup table based firmware to evaluate the output signal.

Some hardware issues were identified and already fixed for v1.1 (https://github.com/sinara-hw/Shuttler/issues/30). Beside that, an issue with bandwidth was identified (https://github.com/sinara-hw/Shuttler/issues/36). Hope to have a decision on fix / nofix soon (you're welcome to contribute).

We did not test AFE at TechnoSystem yet.

Ongoing efforts:

- AFE testing + resolving encountered issues
- finalize v1.1
- manufacture v1.1.

We're hoping to start v1.1 manufacturing in ca 3 weeks from now.

Closed 2023-11-30.

Thread 27 (2022-01-15):

Schematics details

kaolpr, 2022-01-15:
- [x] Add a clear statement in schematics which VADJ values are supported.
- [x] Expand power budget note, when using online viewer it is impossible to see contents.

kaolpr, 2023-03-21:
* [ ] Update copyright year
* [ ] Fix missing image in the project table
* [ ] Add project version to document names
* [ ] Remove floating net label on the top sheet
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

Closed 2024-03-14.

Thread 28 (2022-02-02):

DAC_AFE-resistances

giozara, 2022-02-02:
In the DAC_AFE schematics the resistances on the ADA4896 are different from the one in the note. Is that intentional or is there a reason which eludes me?

giozara, 2022-02-02:
@gkasprow @kaolpr

gkasprow, 2022-02-02:
It's just an opamp. We need resistances that give required gain. I don't see any reason to use the same as in the datasheet

giozara, 2022-02-02:
I was just wondering, because the note in the same schematic specifies higher values which would lead to a higher gain than the one currently chosen. Were the previous (higher gain resistance pair) railing it?

gkasprow, 2022-02-03:
It's possible there is some error. Did you calculate the entire gain budget from the DAC up to the AFE output?
Here are my simulations and calculations
[SIM_CALC.zip](https://github.com/sinara-hw/Shuttler/files/7995421/SIM_CALC.zip)

Thread 30 (2022-08-04):

HW issues

gkasprow, 2022-08-04:
- [x] Missing fiducials on PSU board
- [x] Add 12V / GND testpoints on PSU board
- [x] PGFB must be 3.2V ;
- [x] R11=10k or 11k
- [x] R2=33k
- [x] R6=22k ?
- [x] R15=47k?
- [x] R7=100R

gkasprow, 2022-08-04:
- [ ] check PGFB on AFE board and correct resistors

kaolpr, 2023-03-20:
In current revision (`v1.1rc1`) there is an assembly variant to connect `OSC1` either by `VADJ_BUF`  or `P1V8A`. Following note on the top sheet, the only supported `VADJ` is 1.8V. If this is our design assumption, which AFAIK is a completly valid assumption when designing FMC module, what for is that assembly variant included?

kaolpr, 2023-03-21:
> OSC1 and IC3 - Si53340 with VDD=1.8V is not capable to receive LVPECL signal (according to DS). VDD should be connected to 2.5 V or R12 R13 (LVPECL resistors) should be removed.

It is marked as done, but R12 and R13 are marked DNP only in variant. If we assume that VADJ is always 1.8V then those can be removed instead of DNP.

Closed 2024-03-14.

Thread 31 (2022-09-13):

mechanical issues

gkasprow, 2022-09-13:
move the IPASS and LEDs 0.5mm up
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

gkasprow, 2024-01-22:
I don't remember exactly; I think it was due to the distance between the bottom connector and the panel and the difficulty of milling.

Thread 32 (2022-10-04):

FMC VIO_B_M2C not connected

kaolpr, 2022-10-04:
It looks like a wider problem with our open-source FMC ecosystem. `VIO_B_M2C` should be provided by the mezzanine and be used to supply IO for HBxx signals. See VITA57 rule 6.8: *"The carrier card shall utilize VIO_B_M2C as the supply voltage to the FPGA to provide the signaling standards on HBxx_y signals."*

Now, Shuttler leaves those lines floating.

Most of OHWR-related carriers just ignore those lines (AFC3, AFC4, AFCK, AFCKU) and supply HB IO from VADJ (or fixed 1.8V). DIOT FMC Carrier do have an assembly option to choose between `VIO_B_IO` and fixed 1.8V, but EEM FMC Carrier does not.

Everything is fine as long as you use affected FMC with one of those carriers. However, trying to use it with some FMC-complient carrier (e.g. Digilent Genesys2 orTrenz TEF1001),  results in unpowered (or rather partially powered via signal lines) FPGA bank.

Also trying to use FMC-complient FMC with one of those carriers may lead to having incompatibility of the electric levels.

This can be easily solved with passing through `VADJ` to `VIO_B_M2C` as an assembly variant.

gkasprow, 2024-03-18:
shouldn't we set R12 as DNP?

maciejprzybysz, 2024-04-03:
Updated in v1.2rc2

Closed 2024-03-14.

Thread 33 (2022-10-04):

Invalid input circuit for Si53340

kaolpr, 2022-10-04:
Input circuit arrangement for Si53340 / CLK1 (CLK0 not tested yet, but probably alike) is invalid. Termination resistor should be placed after AC decoupling capacitors. Otherwise Si53340 input bias resistors force P and N lines to have different common mode what results in no output signal.

Moving R21 after C23/C24 solves the issue.

gkasprow, 2023-02-01:
the same applies to R33

Closed 2023-06-07.

Thread 34 (2023-02-07):

v1.1rc1 review

filipswit, 2023-02-07:
**FMC**

- [x] There are some unmasked vias, one under U2 close to thermal pad might be risky
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

- [x] Panel mounting holes have different shapes, top one could be changed to bean one like bottom
- [x] Missing P4 and L5 in production files
- [x] ManufacturerPartNumber collumn can be added to PnP

**AFE**

- [x] Missing L3 in production files
- [x] ManufacturerPartNumber collumn can be added to PnP

**PSU**

- [x] Missing L3 in production files
- [x] ManufacturerPartNumber collumn can be added to PnP

**SAS ufl**

- [x] Unconnected P1 and P2 layers
- [x] 3D models can be moved from M1 to M13

Closed 2023-06-19.

Thread 35 (2023-02-23):

AFE AUX PSU connection crossed

kaolpr, 2023-02-23:
Shuttler AFE was supposed to be compatible with AUX PSU:
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
However, this would require crossed cable (1-3 crossed):
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

gkasprow, 2023-02-23:
We would make cables anyway. They are usually available with a plug on one side.
But it's good to fix it in new revision

kaolpr, 2023-02-23:
Can we still make it to v1.1?

gkasprow, 2023-02-23:
yes
Did we produce the v1.0 prototypes?

kaolpr, 2023-02-23:
Yes. We have one.

gkasprow, 2023-02-27:
fixed
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

maciejprzybysz, 2024-01-22:
In v1.1 the pinout is still incorrect.

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

maciejprzybysz, 2024-03-14:
AUX_PSU would be updated, Shuttler AFE will be not changed.

Closed 2024-03-14.

Thread 36 (2023-02-28):

Shuttler analog bandwidth

jmatyas, 2023-02-28:
According to wiki, Shuttler's analog bandwidth is supposed to be around ~15 MHz, however after some testing on Shuttler v1.0 it seems to be closer to 6 MHz :

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

To achieve those results:

- a sinusoidal signal with a given frequency was generated on DAC channel
- peak-peak amplitude on one of the DAC channel's analog output (after AFE) was measured
- signal frequency was changed and the measurement was repeated

kaolpr, 2023-03-20:
@dhslichter @adbr8389 @gkasprow How do you find current bandwidth? Do we need to fix AFE to follow statement in Wiki (~15 MHz)?

kaolpr, 2023-03-20:
AFAIK this was measured before AFE. Tomorrow I'll ask @jmatyas to provide more details.

kaolpr, 2023-03-20:
But the main question is - was this intended? The simulation @gkasprow provided in #28 seems to confirm that DAC_AFE (the one on FMC) was designed for ~6 MHz.

dhslichter, 2023-03-20:
the op amps have 100 MHz GBW so I thought we would be able to get more than this? However, if we can't go any higher than what is shown here, that is probably still acceptable.

adbr8389, 2023-03-23:
What is the IC used for the differential amp after the ADA4896's? If it has some small capacitive input, I think it could explain the small discrepancy between Daniel's estimation of a 33 pF cap for a 15 MHz bandwidth.

dhslichter, 2023-03-23:
The 33 pF = 15 MHz was only a coarse estimate, I think this seems reasonable. Glad to see that this increased the bandwidth @kaolpr. Next question is whether we should increase further (e.g. 10 pF, or just DNP this capacitor). I would be in favor of testing with capacitors removed and ensuring the op amp outputs are stable (they should be, since we are at G=5). This gives maximum bandwidth out of the FMC card. One can always use following components to reduce the bandwidth as desired for applications, but this would make the FMC card maximally useful for different tasks.

Closed 2024-03-14.

Thread 38 (2023-08-08):

AFE Demultiplexer

andrewvh4, 2023-08-08:
Feature request:

Considering the proposal outlined in: [Malinowski et al, 2023: How to wire a 1000-qubit trapped ion quantum computer](https://arxiv.org/pdf/2305.12773.pdf)

An AFE capable of output demultiplexing might be useful for large-scale trapped ion systems. Has there been any discussion around this idea as a future Shuttler AFE?

gkasprow, 2023-08-09:
this is exactly what we are doing at the WUT right now
https://github.com/sinara-hw/meta/issues/46

dhslichter, 2023-08-22:
@andrewvh4 It would be possible to make a switching-based AFE of the type you mention, but this is a major technical undertaking to figure out exactly how it should work, and there is not a large demand for it right now. If your group is interested in pursuing this, you should come up with a basic plan and post it, and then people can comment. What is your specific desired use case?

Shuttler is targeting applications where >1 MHz bandwidth is needed (for diabatic transport operations, or for parametric modulation of trapping potentials). For slower operations, Zotino and Fastino have higher channel densities and are more space/cost efficient.

maciejprzybysz, 2023-11-30:
As there was no follow-up from @andrewvh4 I closed this issue. Feel free to reopen in case of any update in this topic.

Thread 39 (2023-08-29):

ADCLK845: OUT3 requires CMOS Logic but LVDS Logic is set

linuswck, 2023-08-29:
Ctrl_A is set to GND. Thus, according to datasheet, OUT0, OUT1, OUT2, OUT3 is configured to be LVDS logic. However, DAC_CLK7 on OUT3 requires a CMOS output. Then, the DAC on channel 7 will be malfunction.

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

linuswck, 2023-08-31:
I was looking at release review version of schematic. This is fixed in later revision on master.

Closed 2023-08-31.

Thread 41 (2023-10-03):

TEMP_ALARM does not turn off N3V0A PS

tprzywoz, 2023-10-03:
IC4 has stable power input and pull-up PS during TEMP_ALARM. PG_DAC is not low because IC3 and IC1 have no input voltage (both IC44 and IC46 have run/en pins low)

Suggested solution: add diode between PG_DAC and TEMP_ALARM or PG_3V7_5V5 to keep power sequence and allow TEMP_ALARM to drive low state PG_DAC signal.

Closed 2024-03-14.

Thread 43 (2024-04-04):

AFE control standarization

gkasprow, 2024-04-04:
Can we make uniform pinout of each AFE connector?
I'm implementing same mini SAS pinout in Fastino-DIOT.
And now in the Shuttler the pinout looks in following way

0 CSN0
1 SCLK
2 MOSI0
3 CSN1
4 MISO0
5.MISO1
6.
7.
8. SCLK2
9. MOSI2
10. CSN2
11. IO
12 MISO2
13 IO
14
15

the idea is to have same signalling in every mSAS connectors.
So I'd suggest swapping sime lines in the second connector  so they are compatible with the first connector
AFE CTRL
0 CSN0
1 SCLK
2 MOSI0
3 CSN1
4 MISO0
5.MISO1
6. GPIO
7. GPIO

8. CSN2
9. SCLK2
10. MOSI2
11. CSN3
12 MISO2
13 MISO3
14. GPIO
15. GPIO

lines 6/14 and 7/15 could be used as connector ID where AFE pulls them up or down with resistors.

Thread 44 (2024-11-23):

SAS connector

dhslichter, 2024-11-23:
The current SAS connectors on the Shuttler FMC and AFE boards mate with a cable connector (SFF-8087) that is used for internal cables only, as far as I can tell. I have not been able to find cables available that are over 1 m in length, and the mechanical robustness and electrical shielding are not as good as for external SAS cables.

The external mini-SAS HD cables appear to be much more widely available and in many more lengths. The only drawback is that these don't have sidebands, so we would need to select a second cable for the serial communications between the Shuttler FMC and Shuttler AFE (minimum 12 pins, ideally 16 pins).

Could we consider using two 4x mini-SAS HD cables for the voltages (and corresponding connectors on FMC and AFE cards) -- something like [these](https://www.digikey.com/en/products/detail/te-connectivity-amp-connectors/2337815-4/9866332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) ([see drawing](https://www.te.com/commerce/DocumentDelivery/DDEController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)) ? This would do 16 analog channels, and you can get arbitrary cable lengths. Then we would choose some appropriate other multi-pin cable (shielding/pairing much less important) to send the digital logic signals between FMC and AFE cards.

Thoughts @gkasprow? Or is there a good source of SFF-8087 cables of longer lengths and good mechanical robustness that you use?

gkasprow, 2024-11-23:
we are using ones from 3M
8F36-AAA105-xxx where xxx is length
for example [4m ones](https://www.digikey.pl/en/products/detail/8F36-AAA105-4.00/8F36-AAA105-4.00-ND/5093827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)
