sinara-hw/FMC_Shuttler/(list of files, drawings)

Other design files:
AFE_Buffer.SchDoc
Clock_circuit.SchDoc
DAC_AFE.SchDoc
DACs.SchDoc
EEPROM_Temp.SchDoc
FMC connector.SchDoc
FMC_DAC_125M_14B_16CHA.PrjPCB
FMC_DAC_125M_14B_16CHA.SchDoc
FMC_DAC_125M_14B_16CHA/DACs.SchDoc
power_supply.SchDoc
References.SchDoc
SAS_Connectors.SchDoc
Shuttler_AFE/Shuttler_AFE.PrjPCB
