sinara-hw/FMC_Shuttler/(commit log)

2019-07-25 Fixed 'Sayma issues'
    [Amplifier.SchDoc, CPU_LPC1776.SchDoc, Clk_recovery.SchDoc, Clock_Distribution_PLL.SchDoc, DAC_LTC2000.SchDoc, DACs.SchDoc, DDMTD.SchDoc, ETH_PHY_RMII.SchDoc]
2020-09-23 sch ready for review
    [AFE_Buffer.SchDoc, AMC_Connector.SchDoc, Amplifier.SchDoc, CPU_LPC1776.SchDoc, Clk_recovery.SchDoc, Clock_Distribution_PLL.SchDoc, Clock_circuit.SchDoc, DAC_AFE.SchDoc]
2020-11-12 schematic review
    [AFE_ADC.SchDoc, AFE_Buffer.SchDoc, AFE_CTRL_Logic.SchDoc, Clock_circuit.SchDoc, DAC_AFE.SchDoc, DACs.SchDoc, EEPROM_Temp.SchDoc, FMC connector.SchDoc]
2020-11-18 initial FMC PCB routing done, several schematic fixes done, mostly #18 and #17
    [AFE.xlsx, AFE_ADC.SchDoc, AFE_Buffer.SchDoc, AFE_CTRL_Logic.SchDoc, AFE_Supply.SchDoc, Clock_circuit.SchDoc, DAC_AFE.SchDoc, DACs.SchDoc]
2021-02-23 Shuttler AFE layout v1.0rc1
    [AFE_ADC.SchDoc, AFE_Supply.SchDoc, FMC_DAC_125M_14B_16CHA.PrjPCB, SAS_Connectors.SchDoc, Shuttler_AFE.PrjPCB, Shuttler_AFE.SchDoc, Shuttler_AFE_Channel.SchDoc, Shuttler_AFE_SAS_CON.SchDoc]
2022-10-12 panel update
    [AFE.xlsx]
2024-03-14 v1.2rc1
    Issues fixed:
    - [x] TEMP_ALARM does not turn off N3V0A PS #41
    - [x] [FMC_DAC_PSU] Wrong PN in R130 #37
    - [x] FMC VIO_B_M2C not connected #32
    - [x] HW issues #30 (remove R12/R13)
    - [x] Schematics details #27
    - [ ] AFE AUX PSU connection crossed #35 -> (AUX PSU will be changed accordingly)
    - [x] mechanical issues #31
    - [x] Shuttler analog bandwidth #36 -> 33pF caps -> ~12MHz BW.
    Other fixes:
    - [x] Shuttler FMC stackup adjusted
    - [x] Added missed templates
    - [x] P_version project parameter added
    - [x] Shuttler AFE stackup table added
    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
    [AFE_ADC.SchDoc, AFE_Buffer.SchDoc, AFE_CTRL_Logic.SchDoc, AFE_Supply.SchDoc, Clock_circuit.SchDoc, DAC_AFE.SchDoc, DACs.SchDoc, EEPROM_Temp.SchDoc]
2024-04-03 v1.2rc2 Issues fixed:
    - [x] Shuttler AFE - FTG added
    - [x] Shuttler AFE - keepout for NPTH added
    - [x] R12 marked as DNP
    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
    [FMC_DAC_125M_14B_16CHA.PrjPCB, FMC_DAC_PSU.PrjPCB, Shuttler_AFE.PrjPCB]
2024-06-19 v1.2 - repo cleanup * This repo is only for FMC board form now * AFE, PSU and SAS U.FL adapter were moved to new repos: https://github.com/sinara-hw/AFE_DAC_External https://github.com/sinara-hw/FMC_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
    [AFE.xlsx, AFE_ADC.SchDoc, AFE_Buffer.SchDoc, AFE_CTRL_Logic.SchDoc, AFE_Supply.SchDoc, Clock_circuit.SchDoc, DAC_AFE.SchDoc, DACs.SchDoc]
